EmanuelOrozco/axial-flux-generator/docs/latex/06_presentacion.tex

% Presentación de 10 minutos para público general (incluye la demostración en vivo del simulador).
% Compilar con: ./docs/compilar_pdf.sh 06_presentacion
\documentclass[aspectratio=169,11pt,xcolor={dvipsnames,table}]{beamer}
\usepackage[utf8]{inputenc}
\usepackage[T1]{fontenc}
\usepackage{lmodern}
\usepackage[spanish,es-nodecimaldot,es-noshorthands,es-tabla]{babel}
\usepackage{amsmath,amssymb}
\usepackage{siunitx}
\sisetup{output-decimal-marker={.},group-digits=false,per-mode=symbol}
\usepackage{booktabs}
\usepackage{tikz}
\usepackage{tcolorbox}
\usetikzlibrary{arrows.meta,positioning,calc}

\graphicspath{{../../simulacion/graficas/}{figuras/}}
\input{generado/valores.tex}

% ---------------------------------------------------------------- estilo
\definecolor{Azul}{HTML}{0D47A1}
\definecolor{Cian}{HTML}{00838F}
\definecolor{Naranja}{HTML}{E65100}
\definecolor{Rojo}{HTML}{C62828}
\definecolor{Verde}{HTML}{2E7D32}
\definecolor{Gris}{HTML}{455A64}
\definecolor{Cobre}{HTML}{B87333}

\usefonttheme{professionalfonts}
\setbeamercolor{frametitle}{fg=Azul}
\setbeamerfont{frametitle}{series=\bfseries,size=\Large}
\setbeamercolor{structure}{fg=Azul}
\setbeamercolor{block title}{bg=Azul,fg=white}
\setbeamercolor{block body}{bg=Azul!6}
\setbeamercolor{block title alerted}{bg=Naranja,fg=white}
\setbeamercolor{block body alerted}{bg=Naranja!7}
\setbeamercolor{block title example}{bg=Verde,fg=white}
\setbeamercolor{block body example}{bg=Verde!7}
\setbeamertemplate{navigation symbols}{}
\setbeamertemplate{itemize items}[circle]
\setbeamertemplate{blocks}[rounded]
\setbeamertemplate{footline}{%
  \leavevmode\hbox to\paperwidth{%
    \hspace{1em}{\color{Gris}\tiny Electricidad con imanes: un generador de flujo axial}\hfill
    {\color{Gris}\tiny\insertframenumber/\inserttotalframenumber}\hspace{1em}}%
  \vspace{0.6em}}

\newcommand{\dato}[2]{{\small\color{Gris}#1}\\[-1pt]{\Large\bfseries\color{Azul}#2}}

\title{Electricidad con imanes}
\subtitle{Cómo un disco con imanes que gira puede cargar una batería y encender un bombillo}
\date{}

\begin{document}

% ================================================================ 1. Portada  (0:15)
\begin{frame}[plain]
  \begin{tikzpicture}[remember picture,overlay]
    \fill[Azul] (current page.north west) rectangle ([yshift=-4.4cm]current page.north east);
    \node[anchor=north west,text=white,font=\sffamily\bfseries\LARGE,text width=10cm,align=left]
      at ([xshift=1cm,yshift=-1.3cm]current page.north west) {\inserttitle};
    \node[anchor=north west,text=white!85!Azul,font=\sffamily\normalsize,text width=10cm,align=left]
      at ([xshift=1cm,yshift=-2.4cm]current page.north west) {\insertsubtitle};
    \begin{scope}[shift={([xshift=-2.6cm,yshift=-2.2cm]current page.north east)},scale=0.5]
      \foreach \i in {0,...,7} {
        \pgfmathsetmacro{\ang}{45*\i}
        \ifodd\i \def\col{Azul!40}\def\pol{S}\else \def\col{Rojo!80}\def\pol{N}\fi
        \fill[\col] (\ang:2.2) circle (0.55);
        \node[white,font=\bfseries\small] at (\ang:2.2) {\pol};
      }
      \draw[white,line width=1pt] (0,0) circle (3.0);
      \fill[white!70] (0,0) circle (0.35);
    \end{scope}
  \end{tikzpicture}
  \vspace{4.2cm}
  \begin{columns}[T]
    \column{0.5\textwidth}
      \small Un generador de flujo axial, diseñado y simulado\\[2pt]
      \color{Gris}\footnotesize Teoría Electromagnética
    \column{0.42\textwidth}
      \footnotesize\color{Gris}
      Incluye una demostración en vivo del simulador 3D
  \end{columns}
\end{frame}

% ================================================================ 2. Qué construimos  (0:45)
\begin{frame}{¿Qué construimos?}
  \centering
  \begin{tikzpicture}[
      caja/.style={draw=Azul,fill=Azul!6,rounded corners=3pt,minimum height=1.05cm,
                   text width=1.75cm,align=center,font=\scriptsize},
      flecha/.style={-{Stealth[length=2.2mm]},thick,Gris},
      node distance=0.42cm]
    \node[caja,draw=Naranja,fill=Naranja!8] (mano) {Alguien gira\\el disco};
    \node[caja,right=of mano] (rotor) {Disco con\\\ValPolos{} imanes};
    \node[caja,right=of rotor] (bob) {\ValBobinas{} bobinas\\de cobre};
    \node[caja,right=of bob] (puente) {Convertidor\\AC \(\to\) DC};
    \node[caja,right=of puente] (mppt) {Cargador\\inteligente};
    \node[caja,right=of mppt,draw=Verde,fill=Verde!8] (bat) {Batería\\de \SI{12}{V}};
    \node[caja,below=0.9cm of bat] (inv) {Inversor\\\SI{110}{}/\SI{220}{V}};
    \node[caja,left=of inv,draw=Naranja,fill=Naranja!8] (foco) {Bombillo};
    \draw[flecha] (mano) -- (rotor);
    \draw[flecha] (rotor) -- (bob);
    \draw[flecha] (bob) -- (puente);
    \draw[flecha] (puente) -- (mppt);
    \draw[flecha] (mppt) -- (bat);
    \draw[flecha] (bat) -- (inv);
    \draw[flecha] (inv) -- (foco);
  \end{tikzpicture}

  \vspace{0.5cm}
  \begin{columns}[T]
    \column{0.31\textwidth}
      \begin{block}{La idea}\small
        Convertir movimiento en electricidad, como la dínamo de una bicicleta.
      \end{block}
    \column{0.31\textwidth}
      \begin{block}{El aparato}\small
        Un disco de imanes que gira frente a bobinas de cobre, con piezas impresas en 3D.
      \end{block}
    \column{0.31\textwidth}
      \begin{block}{La simulación}\small
        Un modelo por computador que reproduce el sistema completo en tiempo real.
      \end{block}
  \end{columns}
\end{frame}

% ================================================================ 3. La idea física  (1:00)
\begin{frame}{La idea: un imán en movimiento produce electricidad}
  \centering
  \begin{tikzpicture}[flecha/.style={-{Stealth[length=2.5mm]},very thick,Gris}]
    % imán
    \fill[Rojo!85] (0,0) rectangle (0.8,1.2);
    \fill[Azul!60] (0.8,0) rectangle (1.6,1.2);
    \node[white,font=\bfseries] at (0.4,0.6) {N};
    \node[white,font=\bfseries] at (1.2,0.6) {S};
    \draw[-{Stealth},thick,Naranja] (0,-0.35) -- node[below,font=\scriptsize,text=Naranja]{se mueve} (1.6,-0.35);
    \node[font=\footnotesize,align=center] at (0.8,-1.25) {\textbf{1.} El imán\\pasa cerca};
    \draw[flecha] (2.0,0.6) -- (3.0,0.6);
    % bobina
    \foreach \x in {3.5,3.75,...,4.75} \draw[Cobre,line width=1.6pt] (\x,0.6) ellipse (0.12 and 0.6);
    \node[font=\footnotesize,align=center] at (4.1,-1.25) {\textbf{2.} El campo magnético\\cambia en la bobina};
    \draw[flecha] (5.4,0.6) -- (6.6,0.6);
    % bombillo
    \fill[Naranja!25] (7.6,0.75) circle (0.75);
    \fill[yellow!80!Naranja] (7.6,0.75) circle (0.45);
    \fill[Gris] (7.4,-0.05) rectangle (7.8,0.2);
    \node[font=\footnotesize,align=center] at (7.6,-1.25) {\textbf{3.} Aparece una\\corriente eléctrica};
  \end{tikzpicture}

  \vspace{0.35cm}
  \begin{columns}[T]
    \column{0.47\textwidth}
      \begin{block}{Ley de Faraday}\small
        Cuanto más rápido cambia el campo, más voltaje se genera.
        Por eso, si el disco gira al doble de velocidad, el voltaje se duplica.
      \end{block}
    \column{0.47\textwidth}
      \begin{alertblock}{Ley de Lenz}\small
        La corriente generada frena el imán. Cuanta más electricidad pedimos, más cuesta girar,
        igual que pedalear con la dínamo encendida.
      \end{alertblock}
  \end{columns}
\end{frame}

% ================================================================ 4. El generador por dentro  (0:40)
\begin{frame}{El generador por dentro}
  \begin{columns}[c]
    \column{0.56\textwidth}
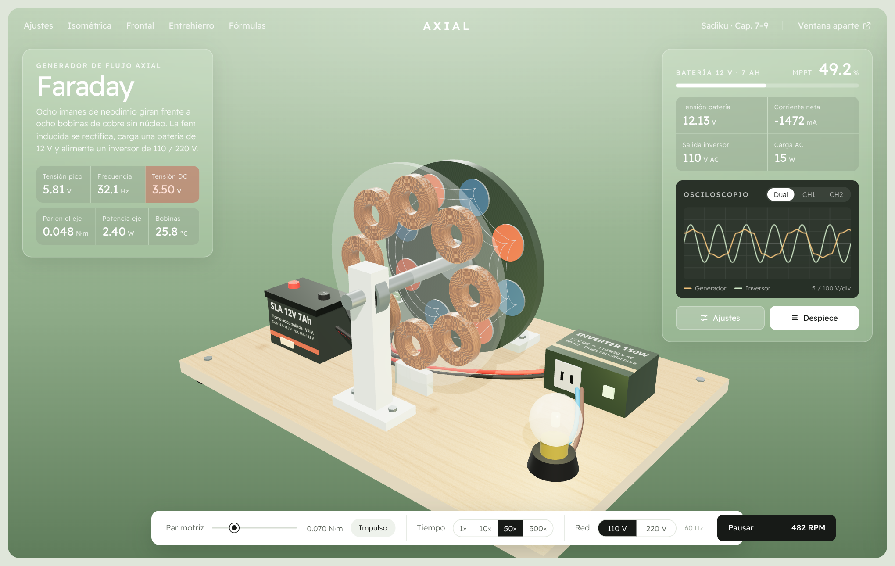
[picture p1: docs/latex/figuras/simulador_despiece.png]
      
    \column{0.41\textwidth}
      \begin{itemize}
        \setlength{\itemsep}{6pt}
        \item \textbf{\ValPolos{} imanes de neodimio}, del tamaño de una moneda (\SI{\ValDiametroIman}{mm}), alternando norte y sur.
        \item \textbf{\ValBobinas{} bobinas} con unos \SI{90}{m} de alambre de cobre en total.
        \item Imanes y bobinas separados solo \SI{\ValEntrehierro}{mm}: el campo se debilita rápido con la distancia.
        \item A \ValRpmReferencia{} vueltas por minuto (5 por segundo) genera unos \SI{\ValTensionRmsRef}{V}.
      \end{itemize}
  \end{columns}
\end{frame}

% ================================================================ 5. Qué tiene en cuenta la simulación  (0:50)
\begin{frame}{Una simulación lo más cercana posible a la realidad}
  \begin{columns}[c]
    \column{0.5\textwidth}
      \small
      \begin{itemize}
        \setlength{\itemsep}{4pt}
        \item \textbf{El disco pesa}: tarda en acelerar y en detenerse.
        \item \textbf{Hay rozamiento}: si se deja de girar, se para solo.
        \item \textbf{El cargador} solo funciona por encima de cierta velocidad.
        \item \textbf{La batería} no es un tanque perfecto: pierde parte de la energía al cargarse y se llena más despacio al final.
        \item \textbf{El inversor} consume energía aunque no haya nada conectado.
        \item \textbf{El calor} aumenta la resistencia del cobre y debilita los imanes.
      \end{itemize}
    \column{0.47\textwidth}
      
      \\{\scriptsize\color{Gris}Un empujón con la mano lleva el disco a unas \ValRpmPicoImpulso{} vueltas por minuto, y se detiene en unos \SI{\ValTiempoParadaImpulso}{s}.}
  \end{columns}
\end{frame}

% ================================================================ 6. Confiabilidad  (0:30)
\begin{frame}{¿Por qué confiar en la simulación?}
  \begin{columns}[T]
    \column{0.31\textwidth}
      \begin{block}{Basada en la física}\small
        Usa las mismas ecuaciones del curso de electromagnetismo (Sadiku).
      \end{block}
    \column{0.31\textwidth}
      \begin{block}{Dos versiones idénticas}\small
        El cálculo en Python y la simulación del navegador coinciden en sus primeras nueve cifras.
      \end{block}
    \column{0.31\textwidth}
      \begin{block}{Probada a fondo}\small
        Cada cambio se verifica con pruebas que revisan física, resultados e interfaz.
      \end{block}
  \end{columns}

  \vspace{0.7cm}
  \begin{columns}[T]
    \column{0.3\textwidth}\centering\dato{Pruebas automáticas}{138}
    \column{0.3\textwidth}\centering\dato{Gráficas generadas}{12}
    \column{0.3\textwidth}\centering\dato{Documentos técnicos}{5}
  \end{columns}
\end{frame}

% ================================================================ 7. Demo  (3:30)
\begin{frame}{Demostración en vivo}
  \begin{columns}[c]
    \column{0.56\textwidth}
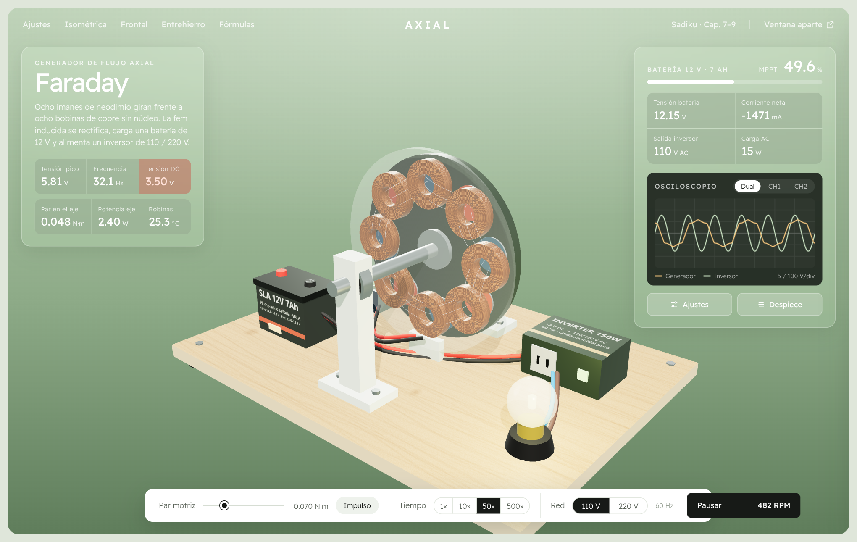
[picture p2: docs/latex/figuras/simulador_general.png]
      
    \column{0.41\textwidth}
      \small
      \begin{enumerate}
        \setlength{\itemsep}{2pt}
        \item Girar el disco y ver la electricidad generada.
        \item Darle un empujón y verlo frenar solo.
        \item Encontrar un giro constante.
        \item Encender el bombillo con la batería.
        \item Cargar la batería acelerando el tiempo.
        \item Separar imanes y bobinas.
        \item Ver el generador por dentro.
      \end{enumerate}
  \end{columns}
\end{frame}

% ================================================================ 8. Resultados  (0:50)
\begin{frame}{¿Cuánta energía produce?}
  \begin{columns}[T]
    \column{0.31\textwidth}\centering
      \dato{Girando suave}{\ValRpmRegimenRef{} RPM}\\[6pt]
      {\small unas 8 vueltas por segundo}
    \column{0.31\textwidth}\centering
      \dato{Llega a la batería}{\ValPotenciaBateriaRef{} W}\\[6pt]
      {\small suficiente para un LED}
    \column{0.31\textwidth}\centering
      \dato{Aprovechamiento}{\ValEficienciaRef{}\,\%}\\[6pt]
      {\small de cada 10 partes de esfuerzo, 4 llegan a la batería}
  \end{columns}

  \vspace{0.8cm}
  \begin{columns}[T]
    \column{0.47\textwidth}
      \begin{exampleblock}{Girando con toda la fuerza}\small
        Unas \ValRpmParMaximo{} vueltas por minuto y \SI{\ValPotenciaBateriaParMaximo}{W} hacia la batería.
      \end{exampleblock}
    \column{0.47\textwidth}
      \begin{alertblock}{La comparación}\small
        Un bombillo de \SI{15}{W} consume más de lo que el generador produce:
        la batería guarda la energía para usarla después.
      \end{alertblock}
  \end{columns}
\end{frame}

% ================================================================ 9. Conclusiones  (0:30)
\begin{frame}{Conclusiones}
  \begin{itemize}
    \setlength{\itemsep}{4pt}
    \item Un imán que se mueve cerca de una bobina genera electricidad: es el mismo principio de las centrales eléctricas.
    \item Generar electricidad siempre cuesta esfuerzo: la corriente frena el disco.
    \item Un generador pequeño produce poca energía, pero con una batería puede acumularla y encender un bombillo.
    \item La simulación permite probar el diseño antes de construirlo.
  \end{itemize}

  \vspace{0.4cm}
  \begin{tcolorbox}[colback=Azul!6,colframe=Azul,boxrule=0.8pt,arc=3pt,halign=center]
    \large\bfseries\color{Azul}
    Con imanes, cobre y movimiento se fabrica electricidad;\\
    la física explica cómo y la simulación muestra cuánto.
  \end{tcolorbox}

  \vspace{0.2cm}
  \begin{center}
    {\Large\bfseries\color{Azul}¿Preguntas?}
  \end{center}
\end{frame}

\end{document}
