EmanuelOrozco/axial-flux-generator/docs/latex/comun/preambulo.tex

% Preámbulo compartido por todos los documentos del proyecto (compilar con pdflatex).
\usepackage[utf8]{inputenc}
\usepackage[T1]{fontenc}
\usepackage{lmodern}
\usepackage{textcomp}
\usepackage[spanish,es-nodecimaldot,es-noshorthands,es-tabla]{babel}
\DeclareUnicodeCharacter{03A9}{\ensuremath{\Omega}}
\DeclareUnicodeCharacter{00B5}{\ensuremath{\mu}}
\DeclareUnicodeCharacter{03BC}{\ensuremath{\mu}}
\DeclareUnicodeCharacter{221A}{\ensuremath{\surd}}
\DeclareUnicodeCharacter{2192}{\ensuremath{\rightarrow}}
\DeclareUnicodeCharacter{2248}{\ensuremath{\approx}}
\DeclareUnicodeCharacter{2212}{\ensuremath{-}}
\DeclareUnicodeCharacter{2264}{\ensuremath{\le}}
\DeclareUnicodeCharacter{2265}{\ensuremath{\ge}}
\DeclareUnicodeCharacter{00D7}{\ensuremath{\times}}
\usepackage[a4paper,top=2.5cm,bottom=2.5cm,left=2.4cm,right=2.4cm,headheight=15pt]{geometry}
\setlength{\emergencystretch}{3em}
\usepackage{amsmath,amssymb,mathtools,bm}
\usepackage{siunitx}
\sisetup{output-decimal-marker={.},group-digits=false,per-mode=symbol,separate-uncertainty}
\usepackage{graphicx,float,booktabs,tabularx,longtable,array,multirow}
\usepackage[font=small,labelfont=bf]{caption}
\usepackage{enumitem}
\setlist{itemsep=2pt,topsep=4pt}
\usepackage[dvipsnames,table]{xcolor}
\usepackage[most]{tcolorbox}
\usepackage{tikz}
\usetikzlibrary{arrows.meta,positioning,shapes.geometric,calc,fit,backgrounds,decorations.markings}
\usepackage[european,straightvoltages]{circuitikz}
\usepackage{listings}
\usepackage{fancyhdr}
\usepackage{titlesec}
\usepackage{xurl}
\usepackage[colorlinks=true,linkcolor=Azul,urlcolor=Azul,citecolor=Azul]{hyperref}

\graphicspath{{../../simulacion/graficas/}{figuras/}}

% ---------------------------------------------------------------- colores
\definecolor{Azul}{HTML}{0D47A1}
\definecolor{Cian}{HTML}{00838F}
\definecolor{Naranja}{HTML}{E65100}
\definecolor{Rojo}{HTML}{C62828}
\definecolor{Verde}{HTML}{2E7D32}
\definecolor{Gris}{HTML}{455A64}
\definecolor{FondoCodigo}{HTML}{F5F7FA}

% ---------------------------------------------------------------- títulos
\titleformat{\section}{\Large\bfseries\color{Azul}}{\thesection}{0.8em}{}
\titleformat{\subsection}{\large\bfseries\color{Cian}}{\thesubsection}{0.8em}{}
\titleformat{\subsubsection}{\normalsize\bfseries\color{Gris}}{\thesubsubsection}{0.8em}{}

% ---------------------------------------------------------------- cabeceras
\pagestyle{fancy}
\fancyhf{}
\fancyhead[L]{\small\color{Gris}\nombredocumento}
\fancyhead[R]{\small\color{Gris}Generador de flujo axial con imanes NdFeB}
\fancyfoot[C]{\small\thepage}
\renewcommand{\headrulewidth}{0.4pt}

% ---------------------------------------------------------------- cajas
\newtcolorbox{nota}[1][Nota]{enhanced,breakable,colback=Azul!4,colframe=Azul!70,
  fonttitle=\bfseries,title={#1},left=6pt,right=6pt}
\newtcolorbox{advertencia}[1][Advertencia]{enhanced,breakable,colback=Rojo!4,colframe=Rojo!80,
  fonttitle=\bfseries,title={#1},left=6pt,right=6pt}
\newtcolorbox{resultado}[1][Resultado]{enhanced,breakable,colback=Verde!5,colframe=Verde!75,
  fonttitle=\bfseries,title={#1},left=6pt,right=6pt}
\newtcolorbox{paso}[1]{enhanced,breakable,colback=white,colframe=Cian!80,
  fonttitle=\bfseries,title={#1},left=6pt,right=6pt}

% ---------------------------------------------------------------- código
\lstdefinestyle{base}{
  basicstyle=\ttfamily\footnotesize,
  backgroundcolor=\color{FondoCodigo},
  frame=single,rulecolor=\color{Gris!40},
  breaklines=true,columns=fullflexible,keepspaces=true,
  keywordstyle=\color{Azul}\bfseries,
  commentstyle=\color{Verde}\itshape,
  stringstyle=\color{Naranja},
  showstringspaces=false,
  extendedchars=true,
  literate={á}{{\'a}}1 {é}{{\'e}}1 {í}{{\'i}}1 {ó}{{\'o}}1 {ú}{{\'u}}1 {ñ}{{\~n}}1
           {Á}{{\'A}}1 {É}{{\'E}}1 {Í}{{\'I}}1 {Ó}{{\'O}}1 {Ú}{{\'U}}1 {Ñ}{{\~N}}1
           {·}{{$\cdot$}}1 {→}{{$\rightarrow$}}1 {Ø}{{\O}}1 {Ω}{{$\Omega$}}1 {µ}{{$\mu$}}1
           {−}{{-}}1 {²}{{$^2$}}1 {√}{{$\surd$}}1 {≈}{{$\approx$}}1
}
\lstdefinestyle{python}{style=base,language=Python}
\lstdefinelanguage{JavaScript}{
  keywords={const,let,var,function,return,class,constructor,new,if,else,for,while,this,true,false,null,typeof,module,export,import},
  sensitive=true,comment=[l]{//},morecomment=[s]{/*}{*/},morestring=[b]',morestring=[b]",morestring=[b]`
}
\lstdefinestyle{js}{style=base,language=JavaScript}
\lstdefinestyle{consola}{style=base,keywordstyle=\color{black}}

% ---------------------------------------------------------------- utilidades
\newcommand{\vect}[1]{\mathbf{#1}}
\newcommand{\unitario}[1]{\mathbf{a}_{#1}}
\newcommand{\dif}{\mathrm{d}}
\DeclareUrlCommand\archivo{\urlstyle{tt}}
\makeatletter
\newcommand{\filasdesde}[1]{\@@input #1 }
\makeatother

\newcommand{\portada}[3]{%
  \begin{titlepage}
    \begin{tikzpicture}[remember picture,overlay]
      \fill[Azul] (current page.north west) rectangle ([yshift=-7cm]current page.north east);
      \node[anchor=north west,text=white,font=\sffamily\bfseries\Huge,text width=16cm,align=left]
        at ([xshift=2.4cm,yshift=-2.2cm]current page.north west) {#1};
      \node[anchor=north west,text=white!85!Azul,font=\sffamily\Large,text width=16cm,align=left]
        at ([xshift=2.4cm,yshift=-4.6cm]current page.north west) {#2};
    \end{tikzpicture}
    \vspace*{7cm}
    \begin{center}
      \begin{tikzpicture}[scale=0.9]
        \foreach \i in {0,...,7} {
          \pgfmathsetmacro{\ang}{45*\i}
          \ifodd\i \def\col{Azul!70}\def\pol{S}\else \def\col{Rojo!80}\def\pol{N}\fi
          \fill[\col] (\ang:2.2) circle (0.55);
          \node[white,font=\bfseries] at (\ang:2.2) {\pol};
        }
        \draw[Gris,line width=1pt] (0,0) circle (3.0);
        \fill[Gris!40] (0,0) circle (0.35);
      \end{tikzpicture}
    \end{center}
    \vfill
    {\large #3\par}
    \vspace{0.6cm}
    {\small\color{Gris}Basado en M.\,N.\,O. Sadiku, \emph{Elementos de Electromagnetismo}, 3.ª ed., Oxford University Press.\par
    Valores numéricos generados por el paquete \texttt{generador\_axial} (\texttt{uv run generador-axial reporte}).\par}
  \end{titlepage}
}

\input{generado/valores.tex}
