EmanuelOrozco/axial-flux-generator/docs/01_marco_teorico.pdf

# Marco teórico del generador de flujo axial

## Deducción paso a paso de las leyes electromagnéticas que gobiernan el prototipo

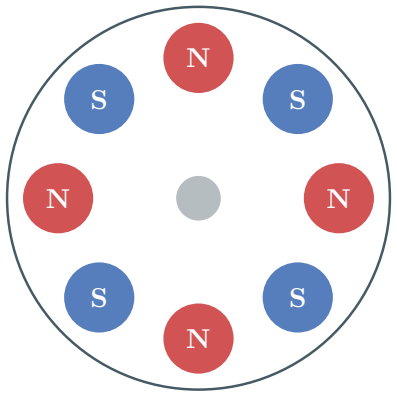
[picture p3: figure]

# Documento 1 de 5 · Fundamentos (Sadiku, Cap. 7, 8 y 9)

Basado en M. N. O. Sadiku, Elementos de Electromagnetismo, 3.ª ed., Oxford University Press.
Valores numéricos generados por el paquete generador_axial (uv run generador-axial reporte).

01 · Marco teórico | Generador de flujo axial con imanes NdFeB

## Índice

1. Objetivo y alcance | 2
2. Magnetostática: de Biot–Savart a la ley de Gauss magnética | 2
3. Materiales magnéticos e imanes de neodimio | 2
4. Campo axial de un imán cilíndrico: deducción completa | 3
5. Flujo magnético y flujo concatenado | 5
6. Ley de Faraday (Sec. 9.2) | 5
7. Fem de transformador y fem de movimiento (Sec. 9.3) | 5
8. Modelo del generador | 6
9. Circuito equivalente, potencia y ley de Lenz | 7
10.Rectificación y filtrado | 8
11.¿Por qué un estator sin núcleo de hierro? | 8
12.Micro-red: batería, controlador de carga e inversor | 8
13.Hipótesis y limitaciones del modelo | 9
14.Resumen de fórmulas | 10

## 1 Objetivo y alcance

Este documento explica por qué funciona el generador y de dónde salen cada una de las ecuaciones que usan el modelo de simulación (src/generador_axial), el visualizador 3D y la guía de fabricación. Ninguna fórmula se presenta sin su deducción: se parte de la ley de Biot– Savart y de la ley de Faraday y se llega, paso a paso, a la tensión que se medirá en los bornes del prototipo.
El generador estudiado tiene la siguiente topología:

Rotor: un disco con P = 8 imanes cilíndricos de NdFeB (∅ 20 × 5.0 mm) montados a un radio de 40.0 mm, con polaridad alternada N–S–N–S.

Estator: un disco fijo con Nb = 8 bobinas de núcleo de aire de N = 180 espiras.

Entrehierro: g = 2.5 mm entre la cara de los imanes y la cara de las bobinas.

Sobre la numeración de Sadiku

Las secciones citadas corresponden a la 3.ª edición en español de Elementos de Electromagnetismo: Cap. 7 (Campos magnetostáticos: Biot–Savart, Ampère, Sec. 7.5 densidad de flujo), Cap. 8 (Fuerzas, materiales y dispositivos magnéticos: Sec. 8.2 fuerzas, Sec. 8.5 imanación, Sec. 8.6 clasificación de materiales) y Cap. 9 (Campos variables: Sec. 9.2 ley de Faraday, Sec. 9.3 fem de transformador y de movimiento). En otras ediciones la numeración puede variar ligeramente.

## 2 Magnetostática: de Biot–Savart a la ley de Gauss magnética

### 2.1 Ley de Biot–Savart (Cap. 7)

Un elemento de corriente I dl produce en un punto situado a un vector R de él la densidad de flujo

dB =

µ0
4π

I dl × aR
R²
, | µ0 = 4π × 10⁻⁷ H/m. | (1)

Para una distribución superficial de corriente K (en A/m) basta sustituir I dl → K dS.

### 2.2 Ley de Gauss para el campo magnético (Sec. 7.5)

I

S

B · dS = 0 | ⇐⇒ | ∇ · B = 0. | (2)

Paso a paso: la forma diferencial se obtiene aplicando el teorema de la divergencia, H
S B · dS = R
V ∇ · B dv = 0, que debe cumplirse para cualquier volumen V ; por tanto el integrando es nulo en todo punto.
Consecuencia para el generador: las líneas de B son cerradas. Todo el flujo que sale de la cara Norte de un imán debe regresar a su cara Sur. En el rotor con polos alternados ese retorno se hace, en buena parte, a través del imán vecino (de polaridad opuesta), lo que concentra el flujo en las bobinas que están enfrente.

## 3 Materiales magnéticos e imanes de neodimio

### 3.1 Imanación y corrientes ligadas (Sec. 8.5)

En un material, los momentos magnéticos atómicos se describen con el vector imanación M (momento dipolar por unidad de volumen, A/m). Se cumple

B = µ0 (H + M). | (3)

Sadiku demuestra que el efecto de M es idéntico al de dos distribuciones de corriente ligada:

Jb = ∇ × M (volumétrica), | Kb = M × an | (superficial). | (4)

### 3.2 Ferromagnéticos duros (Sec. 8.6)

El NdFeB (Nd2Fe14B) es un ferromagnético duro: su ciclo de histéresis es muy ancho. Las dos cifras que lo caracterizan son:

Remanencia Br: densidad de flujo que conserva sin campo externo.

Coercitividad Hc: campo inverso necesario para anular B (> 850 kA/m). Es tan grande que las corrientes inducidas en las bobinas no pueden desmagnetizar el imán.

Tabla 1: Grados comerciales típicos de NdFeB.

Grado | N35 | N38 | N42 | N48 | N52
Br típica [T] 1.19 | 1.24 | 1.30 | 1.40 | 1.45

El prototipo usa Br = 1.25 T (grado N38, cuya remanencia comercial va de 1.22 a 1.26 T).

## 4 Campo axial de un imán cilíndrico: deducción completa

### 4.1 Paso 1: el imán es un solenoide equivalente

Un imán cilíndrico de radio R y espesor L con imanación uniforme M = M az cumple:

1. En el interior M es constante, así que Jb = ∇ × M = 0.
2. En las caras planas an = ±az, de modo que Kb = Maz × (±az) = 0.
3. En la cara lateral an = aρ, de modo que Kb = Maz × aρ = M aϕ.

Es decir, el imán equivale a una lámina cilíndrica de corriente azimutal K = M: exac-tamente un solenoide de longitud L con nI = M amperios-vuelta por metro.

### 4.2 Paso 2: campo de una espira circular en su eje

Tomemos una espira de radio R en el plano z

′ = 0 con corriente I, y un punto del eje a una altura z.
1. La distancia de cualquier punto de la espira al punto de observación es √
R² + z

2, constante.

2. Por simetría, las componentes radiales de dB se cancelan dos a dos; sólo sobrevive la axial.
3. El ángulo entre dl y R es 90◦

, y la proyección axial de dB introduce el factor R/√ R² + z

2:

| dBz = | µ0I dl
4π(R² + z
| | | 2)

·

| | | | R
√
| | | | R² + z

2

4. Integrando dl sobre la circunferencia (H dl = 2πR):

B

| espira
z
(z) = µ0IR²

2 (R² + z

| | | | 2) 3/2
. | (5)

### 4.3 Paso 3: superposición de espiras (solenoide finito)

Situamos el imán entre z

′ = −L y z

′ = 0, de forma que su cara Norte está en z = 0 y el espacio de trabajo es z > 0. Una rebanada de espesor dz

′
transporta la corriente K dz

′ y, por (5),

dBz =

µ0KR² dz

′

2 (R² + (z − z

′)
2)

3/2

1. Cambio de variable u = z − z

′
, du = −dz

′
. Los límites cambian: z

′ = −L ⇒ u = z + L;
z

′ = 0 ⇒ u = z.

2. La integral queda Bz =

µ0KR²

2

Z z+L

z

du
(R² + u

2)

3/2

3. Primitiva conocida: Z

du
(R² + u

2)

3/2

=

u
R²

√
R² + u

2

(se comprueba derivando).

4. Evaluando y simplificando R² :

Bz(z) = µ0K
2

"
z + L
p
(z + L)

2 + R²

−

z
√
z

2 + R²

5. Para un imán permanente con permeabilidad de retroceso µr ≈ 1 (NdFeB: 1.05), µ0M = Br. Con K = M:

Campo axial del imán

Bz(z) = Br
2

"
z + L
p
(z + L)

2 + R²

−

z
√
z

2 + R²

(6)

### 4.4 Paso 4: comprobaciones de la fórmula

En la cara (z = 0): Bz(0) = Br
2

L
√
L² + R²

. Para el prototipo, 0.2795 T.

Imán muy largo (L → ∞, z = 0): Bz → Br/2, el valor conocido en el extremo de un solenoide semi-infinito.

Campo lejano (z ≫ R, L): desarrollando en serie se obtiene

Bz ≈

BrR²L

2 d

3

,

con d la distancia al centro del imán. Es el campo de un dipolo m = MπR²L en su eje, B = µ0m/(2πd³
). El paquete de pruebas verifica este límite.

### 4.5 Paso 5: campo medio en el espesor de la bobina

Las espiras de la bobina no están en un único plano: ocupan desde su cara (z = g) hasta su cara posterior (z = g + h), con h = 6.0 mm. Lo correcto es promediar:

B¯
z =

1
h

Z g+h

g

Bz(z) dz.

1. Primitivas de cada término de (6):
Z

z + L
p
(z + L)

2 + R²

dz =

q
(z + L)

2 + R²,

Z

z
√
z

2 + R²

dz =

p
z

2 + R².

2. Definimos F(z) = p
(z + L)

2 + R² −

√
z

2 + R².

Campo medio en la bobina

B¯
z =

Br
2h

h
F(g + h) − F(g)

i
(7)

Corrección respecto a la versión anterior del proyecto

El modelo original evaluaba Bz sólo en z = g (0.2234 T). El promedio exacto da 0.1545 T: la versión anterior sobreestimaba el flujo, y por tanto la tensión, en un 30.8 %.

## 5 Flujo magnético y flujo concatenado

El flujo a través de una superficie S es Φ = R
S B · dS (Wb). Si una bobina tiene N espiras que abrazan prácticamente el mismo flujo, el flujo concatenado es Ψ = NΦ. Para una espira enfrentada a un imán aproximamos

Φmax = k B¯
z πR²
, | (8)

donde πR²
es el área de la cara del imán y k ∈ (0, 1] es el factor de acoplamiento, que agrupa lo que el modelo axial no recoge: la disminución de Bz fuera del eje, el flujo de retorno que atraviesa las espiras exteriores en sentido contrario y la dispersión en el entrehierro. Se usa k = 0.85.

## 6 Ley de Faraday (Sec. 9.2)

E =

I

L

E · dl = −

dΨ
dt

= −N

dΦ
dt
. | (9)

Forma diferencial paso a paso. Para un contorno fijo:

1. H
L E · dl = −

d
dt

Z

S

B · dS = −

Z

S

∂B
∂t · dS (el contorno no se mueve).
2. Teorema de Stokes: H
L E · dl =

R
S

(∇ × E) · dS.

3. Igualando para cualquier superficie S:

∇ × E = −

∂B
∂t . | (10)

## 7 Fem de transformador y fem de movimiento (Sec. 9.3)

Sadiku distingue tres casos:

Espira fija, campo variable: Etr = −

Z

S

∂B
∂t · dS, | (11)

Espira móvil, campo estático: Em =

I

L

(u × B) · dl, | (12)
Caso general: E = Etr + Em. | (13)

La fem de movimiento proviene de la fuerza de Lorentz F = q(E + u × B): para una carga que se mueve con el conductor, u × B actúa como un campo eléctrico efectivo.
Aplicación al generador.

Marco del estator: las bobinas están quietas; en su posición el campo cambia al pasar polos alternos: es una fem de transformador.

Marco del rotor: el campo de los imanes es estático y son las bobinas las que se mueven con u = −ωm × r: es una fem de movimiento.

Ambas descripciones dan el mismo resultado: para u ≪ c las transformaciones de los campos entre marcos se reducen a E′ = E+u× B, de modo que lo que en un marco aparece como ∂B/∂t en el otro aparece como u × B.

## 8 Modelo del generador

### 8.1 Paso polar y frecuencia eléctrica

1. Con P polos repartidos uniformemente, el paso polar es θp = 2π/P (45.0◦ para P = 8).
2. Un ciclo eléctrico completo (N → S → N frente a una bobina) requiere girar dos pasos polares, 2θp = 4π/P.
3. En una vuelta (2π) hay por tanto P/2 ciclos eléctricos.
4. Con RPM/60 vueltas por segundo:

fe =

P
2

·

RPM
60

=

P · RPM
120

, ωm =

2π RPM
60

, ωe = 2πfe =

P
2
ωm. | (14)

### 8.2 Forma del flujo en una bobina

El flujo que atraviesa una bobina es una función periódica del ángulo del rotor con periodo 2θp, y cambia de signo cada θp (polo N → polo S). Su primer armónico de Fourier es

Φ(t) = Φmax cos(ωet), | (15)

tomando t = 0 cuando un imán N está centrado sobre la bobina. El modelo conserva sólo este armónico fundamental, que es el que domina en topologías sin hierro con imanes circulares.

### 8.3 Fem de una bobina

Aplicando (9):

1.

dΦ
dt

= −Φmax ωe sin(ωet) (regla de la cadena).

2. E1(t) = −N

dΦ
dt

= N ωe Φmax sin(ωet).

### 8.4 Conexión en serie con polaridad alternada

La bobina j (j = 0, . . . , Nb − 1) está desplazada un ángulo jθp, por lo que ve Φj (t) = Φmax cos(ωet − jπ) = (−1)j Φmax cos(ωet): las bobinas vecinas tienen flujos opuestos. Si todas se conectaran en el mismo sentido, sus fem se cancelarían por pares. Conectando la bobina j con signo sj = (−1)j
(final con final, inicio con inicio):

Etotal =

N

Xb−1

j=0

sj Ej =

X

j

(−1)j

(−1)j NωeΦmax sin(ωet) = NbN ωeΦmax sin(ωet).

Fem del generador

E(t) = Vpico sin(ωet), | Vpico = Ntotal ωe Φmax, | Ntotal = NbN = 1440. | (16)

### 8.5 Valor eficaz

Por definición V

2
RMS =

1
T

R T
0

E

2dt. Usando sin² x =

1−cos 2x
2

y que el coseno promedia cero en un periodo:

V

2
RMS =

V

2
pico
T

Z T

0

1 − cos(2ωet)
2

dt =

V

2
pico
2

⇒ VRMS =

Vpico
√
2
. | (17)

## 9 Circuito equivalente, potencia y ley de Lenz

### 9.1 Resistencia interna

Para una bobina con diámetros interior Di y exterior De, la espira media tiene diámetro (Di + De)/2:

ℓm = π

Di + De
2
, | Rint = ρCu

Ntotal ℓm

ACu

, ACu =

πd²

4

. | (18)

Corrección

La versión anterior usaba un radio medio de 12 mm; con Di = 12 mm y De = 28 mm el radio medio real es 10 mm. Con el valor corregido, Rint = 12.14 Ω.

Al ser bobinas sin núcleo su inductancia es pequeña y Zint = Rint + jωeLint ≈ Rint.

### 9.2 Teorema de máxima transferencia de potencia

Con una carga resistiva RL (circuito de Thévenin, valores eficaces):

1. I =

VRMS

Rint + RL

, PL = I

2RL =

V

2
RMSRL

(Rint + RL)

2

2. Derivando respecto a RL:

dPL
dRL

= V

2
RMS

(Rint + RL) − 2RL

(Rint + RL)

3

= V

2
RMS

Rint − RL

(Rint + RL)

3

3. Se anula para RL = Rint (es un máximo: la derivada pasa de positiva a negativa).
4. Pmax =

V

2
RMS
4Rint

, con rendimiento η =

RL

Rint + RL

, que vale 50 %.

### 9.3 Ley de Lenz y par resistente

El signo menos de (9) indica que la corriente inducida crea un flujo que se opone a la variación que la produjo. Mecánicamente:

1. Cada tramo de conductor con corriente sufre dF = I dl × B (Sec. 8.2).
2. La reacción sobre los imanes produce un par τ = r × F opuesto a ωm.
3. Conservación de la energía: la potencia mecánica entregada al eje iguala la potencia eléctrica total
Pmec = τ ωm = I

2
(Rint + RL) = PL + PCu | ⇒ | τ =

PL + PCu
ωm
. | (19)

No hay energía gratuita: cuanto más corriente se extrae, más cuesta girar el rotor.

## 10 Rectificación y filtrado

1. En el puente de Graetz conducen dos diodos en serie en cada semiciclo; la tensión de pico disponible en la salida es Vpico − 2VD.
2. El condensador C se carga al valor de pico y, entre picos, alimenta la carga. Con rectificación de onda completa los picos se repiten cada 1/(2fe).
3. Si la carga extrae una corriente casi constante IDC, el condensador pierde ∆Q = IDC/(2fe) y su tensión cae ∆V = ∆Q/C:
VDC ≈ Vpico − 2VD, | ∆Vpp ≈ IDC 2feC
| . | (20)

Con diodos 1N4007 VD ≈ 0.7 V; con Schottky 1N5819 VD ≈ 0.30 V (valor del modelo).

## 11 ¿Por qué un estator sin núcleo de hierro?

Con hierro: µr ∼ 10³ aumenta el flujo, pero aparecen pérdidas por histéresis (∝ f Bn ),
por corrientes parásitas (∝ f

2B²
) y un fuerte par de reluctancia (cogging): el rotor “se engancha” en posiciones preferentes.

Sin hierro (coreless): µr ≈ 1, cero cogging, sin pérdidas en el núcleo, sin saturación. El sistema es lineal y la ley de Faraday se verifica de forma limpia: ideal para un laboratorio.

## 12 Micro-red: batería, controlador de carga e inversor

El generador alimenta una micro-red aislada: controlador DC-DC → batería de 12 V / 7 Ah → inversor de 110 V o 220 V a 60 Hz → bombillo de 15W. La física electromagnética termina en la tensión del generador; el resto es teoría de circuitos y de electrónica de potencia, salvo el transformador del inversor, que vuelve a ser la ley de Faraday.

### 12.1 Modelo de la batería

1. Se modela como una fuente Eoc que depende del estado de carga (SoC) en serie con una resistencia Rbat = 0.05 Ω:
Eoc(SoC) = 11.8 + 1.0 · SoC V, | Vbat = Eoc + InetaRbat. | (21)
2. El SoC se integra con la corriente neta (conteo de Coulomb), con Q = C · 3600 s:

d SoC
dt

=

Icarga − Idescarga
Q
| . | (22)
3. Protección por baja tensión: el inversor se desconecta al 20 % y se reconecta al 25 %. La histéresis evita que la salida oscile en el umbral.

### 12.2 Controlador de carga con seguimiento del punto de máxima potencia

El generador es una fuente de Thévenin con Rint = 12.14 Ω. Un controlador DC-DC que emula una carga RL = Rint extrae, por el teorema de máxima transferencia,

Pmax =

V

2
RMS
4Rint

, Icarga = m´ın

ηc Pmax
Eoc(SoC)

, Imax,

Vabs − Eoc

Rbat

, | (23)

con ηc = 90 %, Imax = 3.0 A y Vabs = 14.4 V. El controlador no arranca si VDC < 3.5 V.

Corrección

La versión modificada del proyecto calculaba la potencia con V

2
DC/(4Rint). Como VDC ≈

Vpico =

√
2 VRMS, eso duplicaba la potencia disponible. La forma correcta usa el valor eficaz de la fem.

### 12.3 Inversor y transformador elevador (Sec. 8.8 y 9.3)

1. Un puente de MOSFET conmuta la batería con modulación senoidal (SPWM); el filtro LC deja sólo el armónico fundamental de 60 Hz.
2. El transformador eleva la tensión por la fem de transformador: ambos devanados comparten el flujo Φ(t), y por Faraday v1 = N1 dΦ/dt y v2 = N2 dΦ/dt. Por tanto

V2
V1

=

N2
N1

≈

155.6 V
12 V
≈ 13.0. | (24)
3. Balance de potencia con eficiencia ηinv = 90 %:

Pin =

PAC

ηinv

, | Idescarga =

PAC

ηinv Eoc

. | (25)

### 12.4 Balance energético y velocidad de equilibrio

La potencia neta que recibe la batería es

Pneta = ηc

V

2
RMS
4Rint

−

PAC

ηinv

. | (26)

Como VRMS ∝ RPM, la velocidad que equilibra el consumo (Pneta = 0) es

RPMeq = RPMref

p
4RintPAC/(ηcηinv)

VRMS(RPMref )

. | (27)

Resultado

Para el bombillo de 15W se necesitan ≈ 1704 RPM, por encima del rango del prototipo (1200 RPM). Por tanto el generador recarga la batería y es la batería la que alimenta el inversor. Una carga de 5W se equilibra a ≈ 984 RPM.

## 13 Hipótesis y limitaciones del modelo

1. Se usa el campo en el eje del imán; fuera del eje Bz es menor (lo absorbe k).
2. Se conserva sólo el armónico fundamental del flujo.
3. Se desprecian la inductancia de las bobinas y la variación de ρCu con la temperatura (≈ 0.39 %/K).
4. El rotor es de una sola cara y sin placa de retorno de hierro; un rotor doble (imanes a ambos lados del estator) aproximadamente duplicaría el flujo.
5. k debe calibrarse con la medición: kreal = k · Vmedido/Vteórico.

## 14 Resumen de fórmulas

Magnitud | Expresión | Unidad
Velocidad angular mecánica | ωm = 2π RPM/60 | rad/s
Frecuencia eléctrica | fe = P · RPM/120 | Hz
Campo axial del imán | Bz = Br
| 2

h
| √ z+L
| (z+L) 2+R² − √ z
| z 2+R²

i
| | T
Campo medio en la bobina | B¯
| z = Br
| 2h - F(g + h) − F(g)
| | T
Flujo máximo por espira | Φmax = k B¯
| z πR² | Wb
Fem pico total | Vpico = Ntotal ωe Φmax | V
Fem eficaz | VRMS = Vpico/

√
| 2 | V
Tensión rectificada | VDC ≈ Vpico − 2VD | V
Rizado | ∆Vpp ≈ IDC/(2feC) | V
Resistencia interna | Rint = ρCuNtotalπ(Di + De)/(2ACu) | Ω
Potencia en la carga | PL = V
| 2
| RMSRL/(Rint + RL)
| 2 | W
Par resistente (Lenz) | τ = (PL + PCu)/ωm | N·m
Tensión de la batería | Eoc = 11.8 + 1.0 · SoC | V
Corriente de carga (MPPT) | Icarga = ηcV
| 2
| RMS/(4RintEoc) | A
Relación del transformador | V2/V1 = N2/N1 | –
Corriente del inversor | Idescarga = PAC/(ηinvEoc) | A

Los valores numéricos de cada una de estas magnitudes para el prototipo se calculan paso a paso en el Documento 2: Memoria de cálculo.
