EmanuelOrozco/axial-flux-generator/docs/02_memoria_de_calculo.pdf

# Memoria de cálculo

## Cálculo numérico paso a paso del prototipo: campo, flujo, tensión, resistencia, potencia y par


# Documento 2 de 5 · Resultados del modelo analítico

Basado en M. N. O. Sadiku, Elementos de Electromagnetismo, 3.ª ed., Oxford University Press.
Valores numéricos generados por el paquete generador_axial (uv run generador-axial reporte).

02 · Memoria de cálculo | Generador de flujo axial con imanes NdFeB

## Índice

1. Cómo se obtuvo cada número | 2
2. Datos de entrada | 2
3. Campo magnético | 2
4. Flujo magnético | 3
5. Cinemática a 300 RPM (velocidad de referencia) | 4
6. Tensión inducida | 4
7. Resistencia interna y ocupación de la bobina | 5
8. Operación con carga a 400 RPM | 6
9. Verificación de la etapa de salida | 7
10.Micro-red a 600 RPM | 7
11.Tabla de ensayos prevista | 10
12.Verificación automática del modelo | 10

## 1 Cómo se obtuvo cada número

Todos los valores de este documento se escriben a partir del archivo docs/latex/generado/ valores.tex, que genera automáticamente el comando

uv run generador-axial reporte

a partir del diseño definido en src/generador_axial/configuracion.py. Si se cambia un parámetro del diseño (por ejemplo, el número de espiras) y se recompilan los PDF con docs /compilar_pdf.sh, todas las cifras de este documento se actualizan solas. Así se evita que la documentación y el código digan cosas distintas.
Cada paso sigue la misma estructura: fórmula (deducida en el Documento 1) → sustitución de los datos → resultado.

## 2 Datos de entrada

Tabla 1: Parámetros del diseño.

Símbolo | Descripción | Valor
Br | Remanencia del imán (grado N38) | 1.25 T
R | Radio del imán (∅ 20 mm) | 10.0 mm
L | Espesor del imán | 5.0 mm
P | Número de polos | 8
rm | Radio de montaje de imanes y bobinas | 40.0 mm
Nb | Número de bobinas | 8
N | Espiras por bobina | 180
Di
, De | Diámetros interior y exterior de la bobina | 12.0 / 28.0 mm
h | Altura (espesor axial) de la bobina | 6.0 mm
g | Entrehierro (cara del imán a cara de la bobina) | 2.5 mm
k | Factor de acoplamiento | 0.85
AWG | Calibre del alambre (cobre ∅ 0.404 mm, esmaltado ∅ 0.455 mm) | 26
ρCu | Resistividad del cobre a 20 ◦C | 1.72×10⁻⁸ Ω·m
VD | Caída por diodo (Schottky) | 0.30 V
C | Condensador de filtro | 220 µF / 50 V
RLED | Resistencia limitadora del LED | 2200 Ω, 0.50 W

## 3 Campo magnético

## Paso 1 · Área de la cara del imán

| Aim = πR² = π (10.0 mm)

2 = 314.16 mm² = 3.1416 × 10⁻⁴ m²

## Paso 2 · Campo en la cara del imán (z = 0)

Con z = 0 el segundo término de la fórmula del campo se anula:

| Bz(0) = Br
| 2 L
√
| L² + R² =
| 1.25
| 2

·

| 5.0
| 11.1803 =
| 1.25
| 2
- 0.4472 = | 0.2795 T

(Las longitudes pueden ir en mm porque aparecen como cociente.)

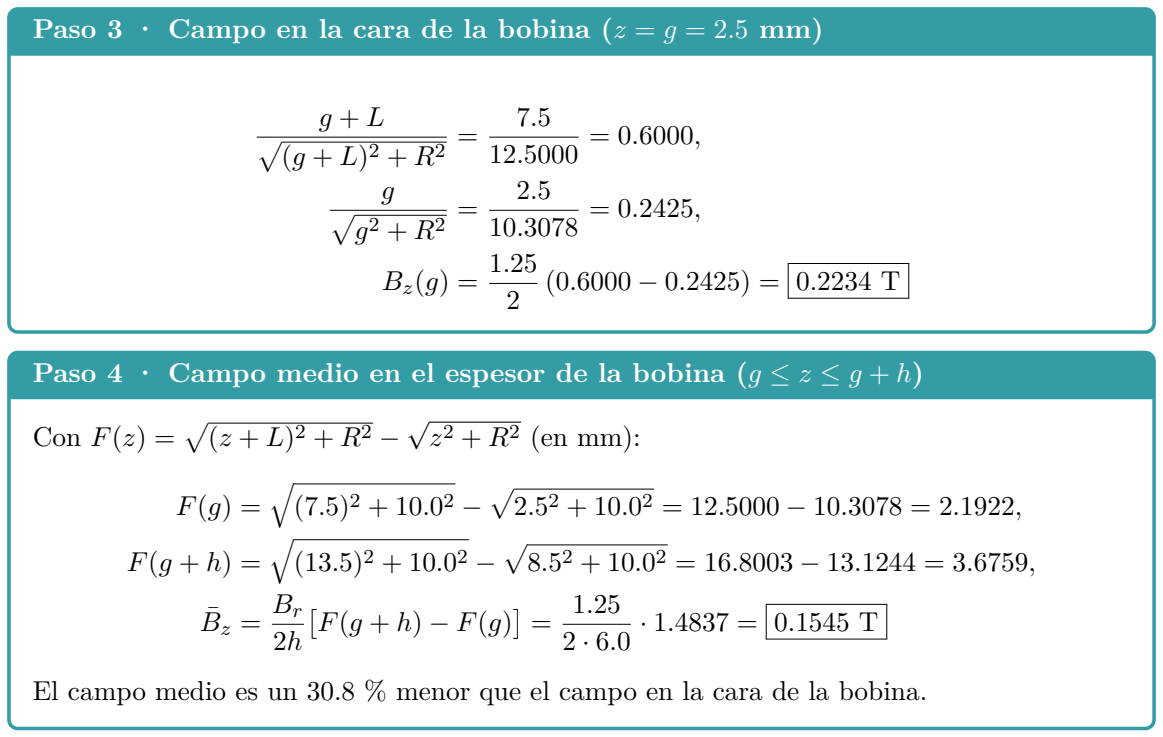
[picture p4: figure]
Con F(z) = p (z + L)

## Paso 3 · Campo en la cara de la bobina (z = g = 2.5 mm)

## Paso 4 · Campo medio en el espesor de la bobina (g ≤ z ≤ g + h)

El campo medio es un 30.8 % menor que el campo en la cara de la bobina.

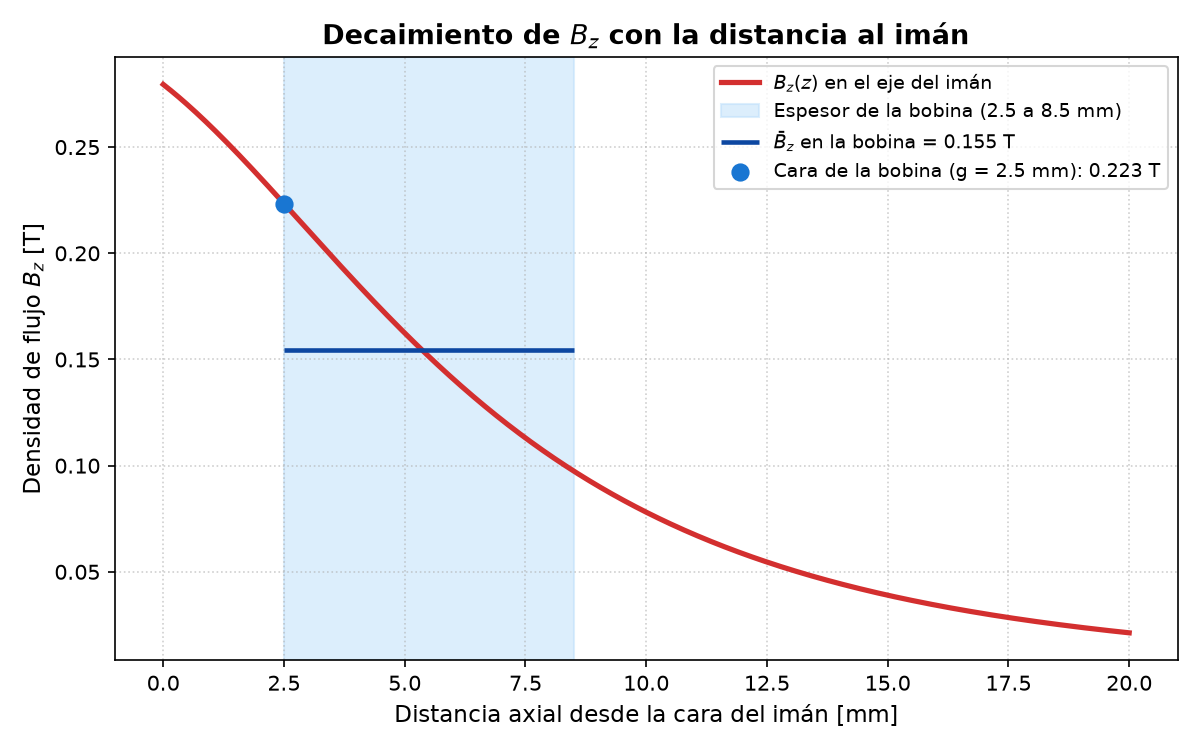
[picture p5: figure]

Figura 1: Campo axial Bz(z). La franja azul es el volumen ocupado por las espiras; la línea horizontal es el promedio B¯
z que se usa en el cálculo del flujo.

## 4 Flujo magnético

## Paso 5 · Flujo máximo por espira

Φmax = k B¯

z Aim = 0.85 × 0.1545 T × 3.1416 × 10⁻⁴ m² = 41.270 µWb

## 5 Cinemática a 300 RPM (velocidad de referencia)

## Paso 6 · Velocidades y frecuencia

ωm =

2π · RPM
60

=

2π · 300
60

= 31.416 rad/s,

fe =

P · RPM
120

=

8 · 300
120
= | 20.00 Hz | ,

ωe = 2πfe =

P
2

ωm = 125.66 rad/s, Te =

1
fe

= 50.00 ms.

## 6 Tensión inducida

## Paso 7 · Fem pico, eficaz y rectificada a 300 RPM

Ntotal = Nb · N = 8 × 180 = 1440,

Vpico = Ntotal ωe Φmax = 1440 × 125.66 × 41.270 × 10⁻⁶ = | 7.47 V | ,

Vpico, bobina = Vpico/Nb = 0.933 V,

VRMS =

Vpico
√
2

=

7.47
1.4142
= | 5.28 V | ,
VDC ≈ Vpico − 2VD = 7.47 − 0.60 = | 6.87 V | .

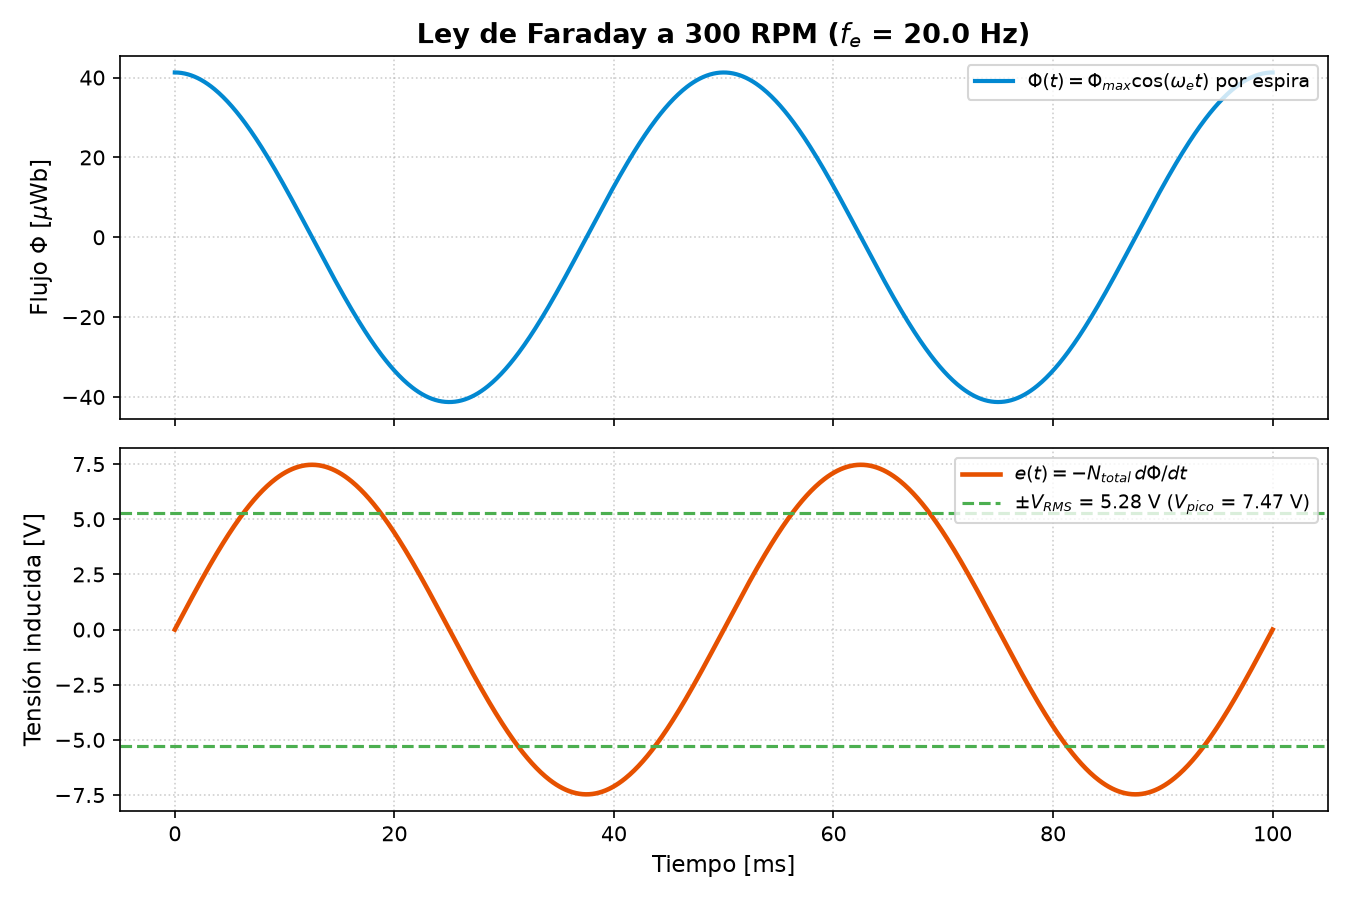
[picture p6: figure]

Figura 2: Flujo por espira Φ(t) y fem total e(t) = −Ntotal dΦ/dt a 300 RPM. La fem es máxima cuando

el flujo pasa por cero (máxima pendiente) y nula cuando el flujo es máximo.

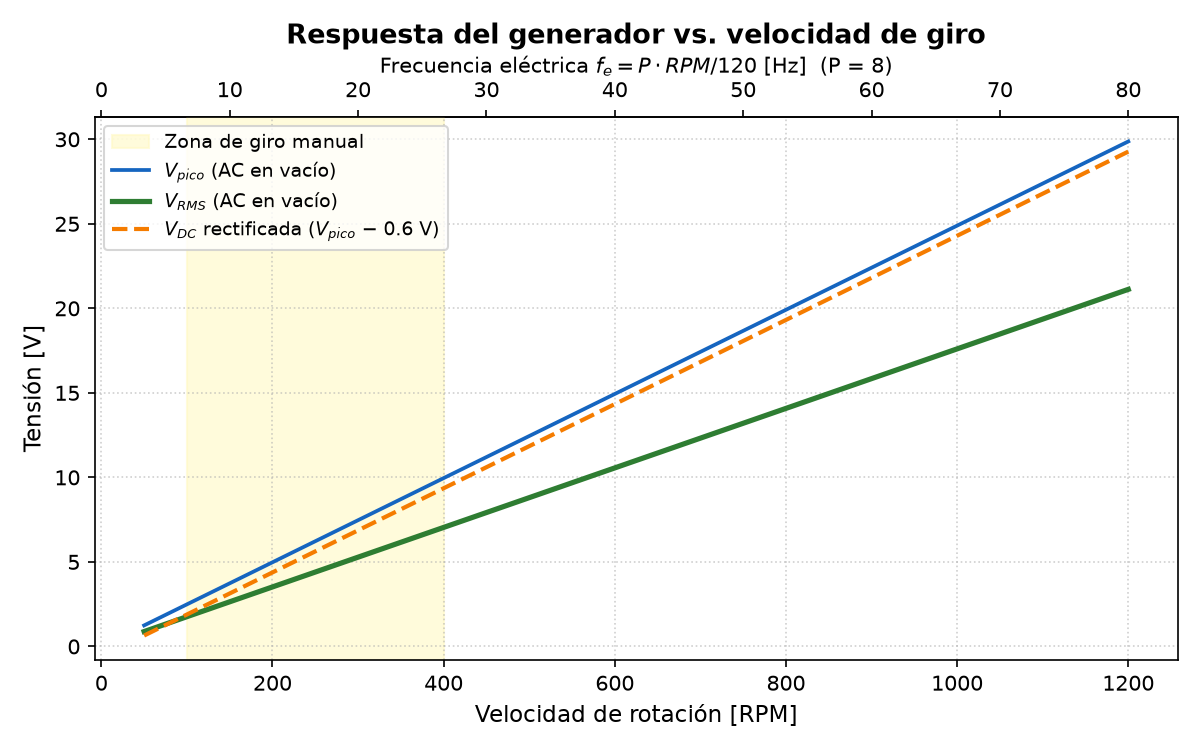
[picture p7: figure]

Figura 3: Las tensiones crecen linealmente con la velocidad porque Vpico ∝ ωe ∝ RPM. El eje superior

muestra la frecuencia eléctrica correspondiente.

## 7 Resistencia interna y ocupación de la bobina

## Paso 8 · Longitud de alambre

ℓm = π

Di + De
2

= π

12.0 + 28.0
2

= 62.83 mm,

Lbobina = N ℓm = 180 × 62.83 mm = 11.31 m,

Ltotal = Nb Lbobina = 90.48 m.

## Paso 9 · Resistencia

ACu =

πd²

4

=

π (0.404)²

4

= 0.1282 mm²
,

Rbobina = ρCu

Lbobina

ACu

= 1.517 Ω,

Rint = Nb Rbobina = | 12.14 Ω | .

Este es el valor que debe medirse con el multímetro entre los terminales de salida (a 20 ◦C).

## Paso 10 · ¿Caben las espiras? (factor de ocupación)

La ventana de bobinado mide De−Di
2 × h = 48.0 mm²
. Si cada espira ocupa un cuadrado de lado igual al diámetro esmaltado:

ocupación =

N d²
esm
ventana

=

180 × 0.455²

| 48.0
= | 0.78

Un valor por debajo de 0.85 es realizable con bobinado manual ordenado. El modelo rechaza diseños con ocupación mayor que 1.

## 8 Operación con carga a 400 RPM

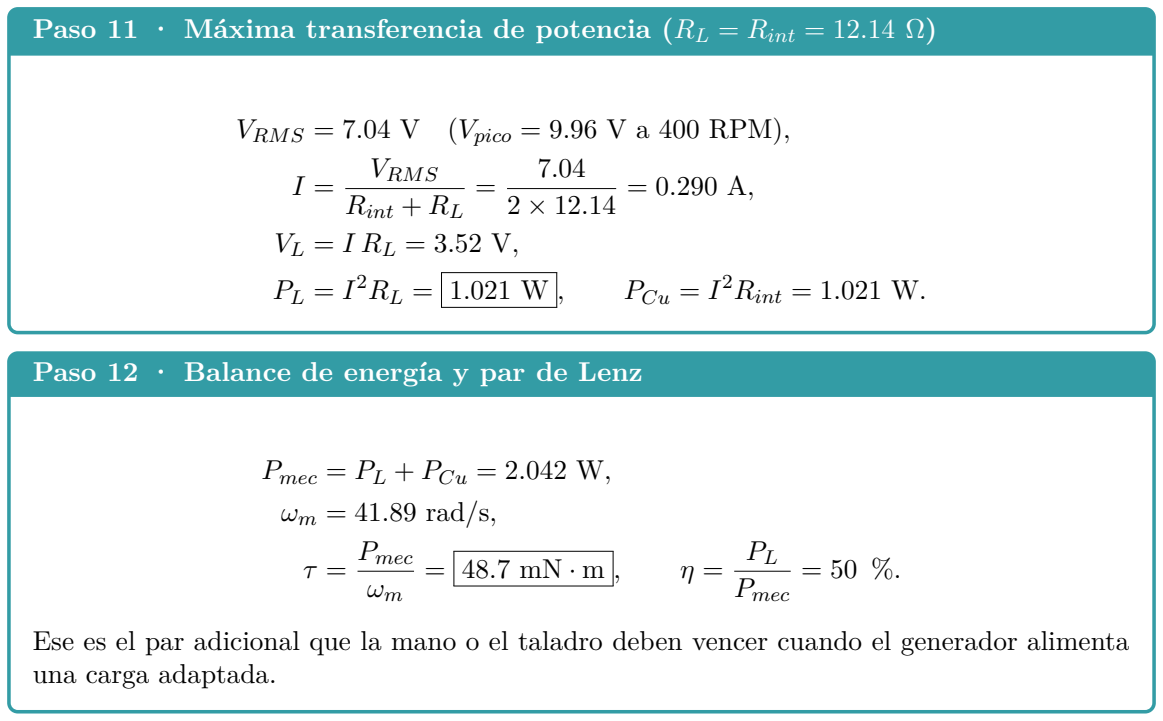
[picture p8: figure]
VRMS; Rint + RL; PCu = I; 2Rint = 1.021 W.; Pmec = PL + PCu = 2.042 W,; ωm = 41.89 rad/s,; Pmec; una carga adaptada.

## Paso 11 · Máxima transferencia de potencia (RL = Rint = 12.14 Ω)

VRMS = 7.04 V (Vpico = 9.96 V a 400 RPM),

## Paso 12 · Balance de energía y par de Lenz

Ese es el par adicional que la mano o el taladro deben vencer cuando el generador alimenta

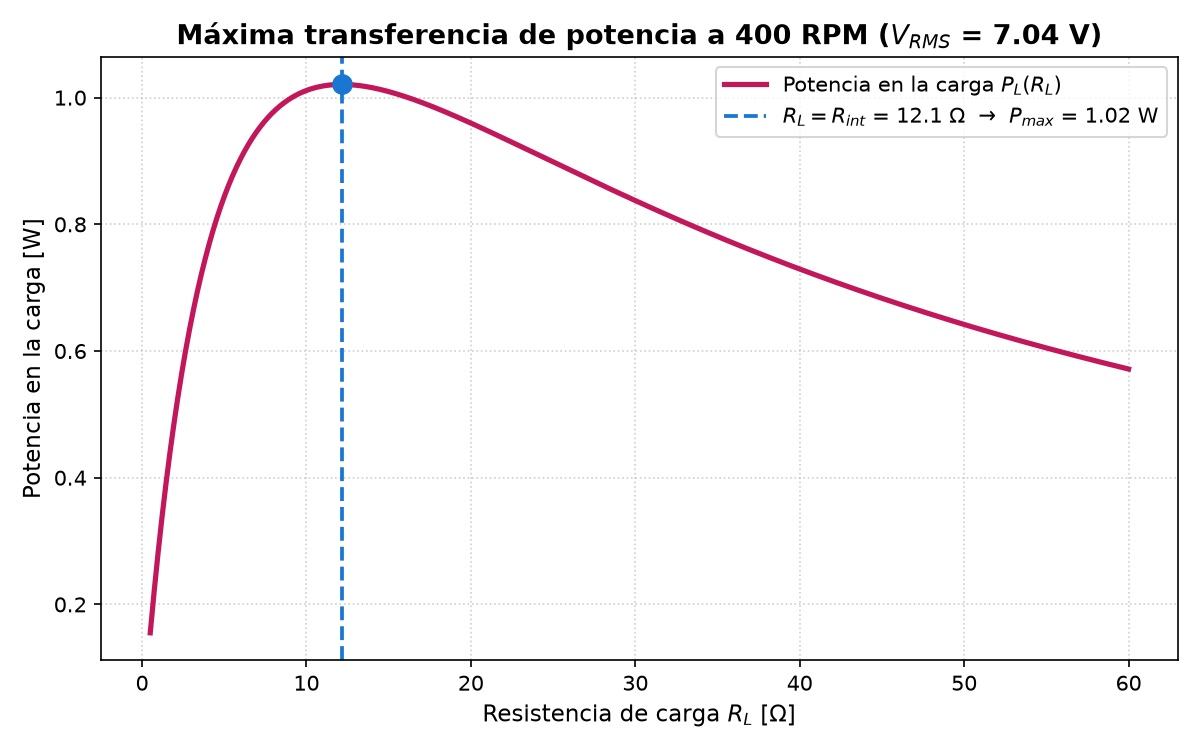
[picture p9: figure]

Figura 4: Potencia en la carga en función de RL: el máximo está exactamente en RL = Rint.

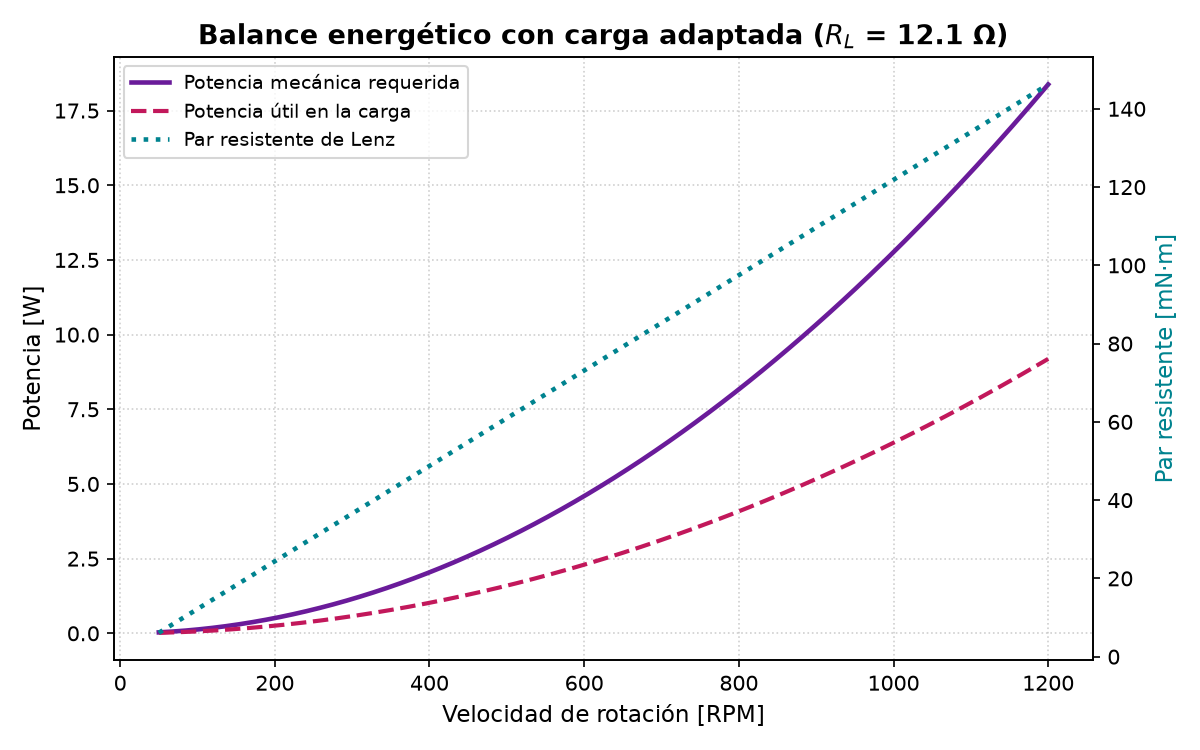
[picture p10: figure]

Figura 5: Con carga adaptada la potencia crece con el cuadrado de la velocidad (P ∝ V 2 ∝ RPM²
) y el
par resistente crece linealmente (τ = P/ωm ∝ RPM).

## 9 Verificación de la etapa de salida

## Paso 13 · Condensador, LED y rizado

Tensión máxima a 1200 RPM: VDC = 29.27 V. El condensador de 50 V queda con

un margen del 41 % (uno de 25 V se dañaría).

LED a 1200 RPM: ILED =

VDC − VLED

RLED

=

29.27 − 2.0
2200

= 12.4 mA (límite 20 mA) y

la resistencia disipa I

2R = 0.338 W (nominal 0.50 W).

Rizado a 300 RPM con el LED como carga (I = 2.21 mA):

∆Vpp =

I
2feC

=

2.21 × 10⁻³
2 × 20.00 × 220 × 10⁻⁶

= 251.4 mV.

## 10 Micro-red a 600 RPM

## Paso 14 · Batería (estado inicial SoC = 50 %)

E = Vnom C = 12 V × 7 Ah = 84 Wh,
Eoc = 11.8 + 1.0 × 0.50 = 12.30 V,
Eutil = (SoC − SoCcorte) E = (0.50 − 0.20) × 84 = 25.2 Wh.

El inversor se desconecta al 20 % y vuelve a conectarse al 25 %.

## Paso 15 · Carga con seguimiento del punto de máxima potencia

VRMS = 10.56 V, VDC = 14.34 V > 3.5 V (arranca),

Pmax =

V

2
RMS
4Rint

=

10.56²
4 × 12.14

= 2.297 W,

Pbat = ηc Pmax = 0.90 × 2.297 = | 2.067 W | ,

Icarga =

Pbat

Eoc

=

2.067
12.30

= 168 mA (< 3.0 A, no se limita),

Pmec = Pmax + I

2Rint = 4.59 W, τ = 73.1 mN · m.

Sin consumo, recargar del 50 % al 100 % tomaría (1 − 0.50) × 7/0.168 ≈ 20.8 h.

## Paso 16 · Inversor de 110 V / 220 V a 60 Hz

Vpico =

√
2 × 110 = 155.6 V (

√
| 2 × 220 = 311.1 V),
N2
N1

≈

155.6
12

= 13.0,

IAC =

PAC

VRMS

=

15
110

= 136 mA,

Pin =

PAC

ηinv

=

15
0.90

= 16.67 W, Idescarga =

Pin

Eoc

= 1.36 A.

La potencia de 15W está muy por debajo de la nominal del inversor (150W).

## Paso 17 · Balance de la batería y autonomía

Pneta = Pbat − Pin = 2.067 − 16.67 = | −14.60 W | ,

tauto ≈

Eutil

|Pneta|

= 1.73 h (1.51 h con el generador parado).

## Paso 18 · Velocidad de equilibrio

Como Pbat ∝ RPM²
, la velocidad que anula Pneta para 15W es

RPMeq = 600r
16.67
2.067

≈ 1704 RPM.

Supera las 1200 RPM del prototipo: con 15W la batería siempre se descarga. Con 5W

el equilibrio se alcanza a ≈ 984 RPM.

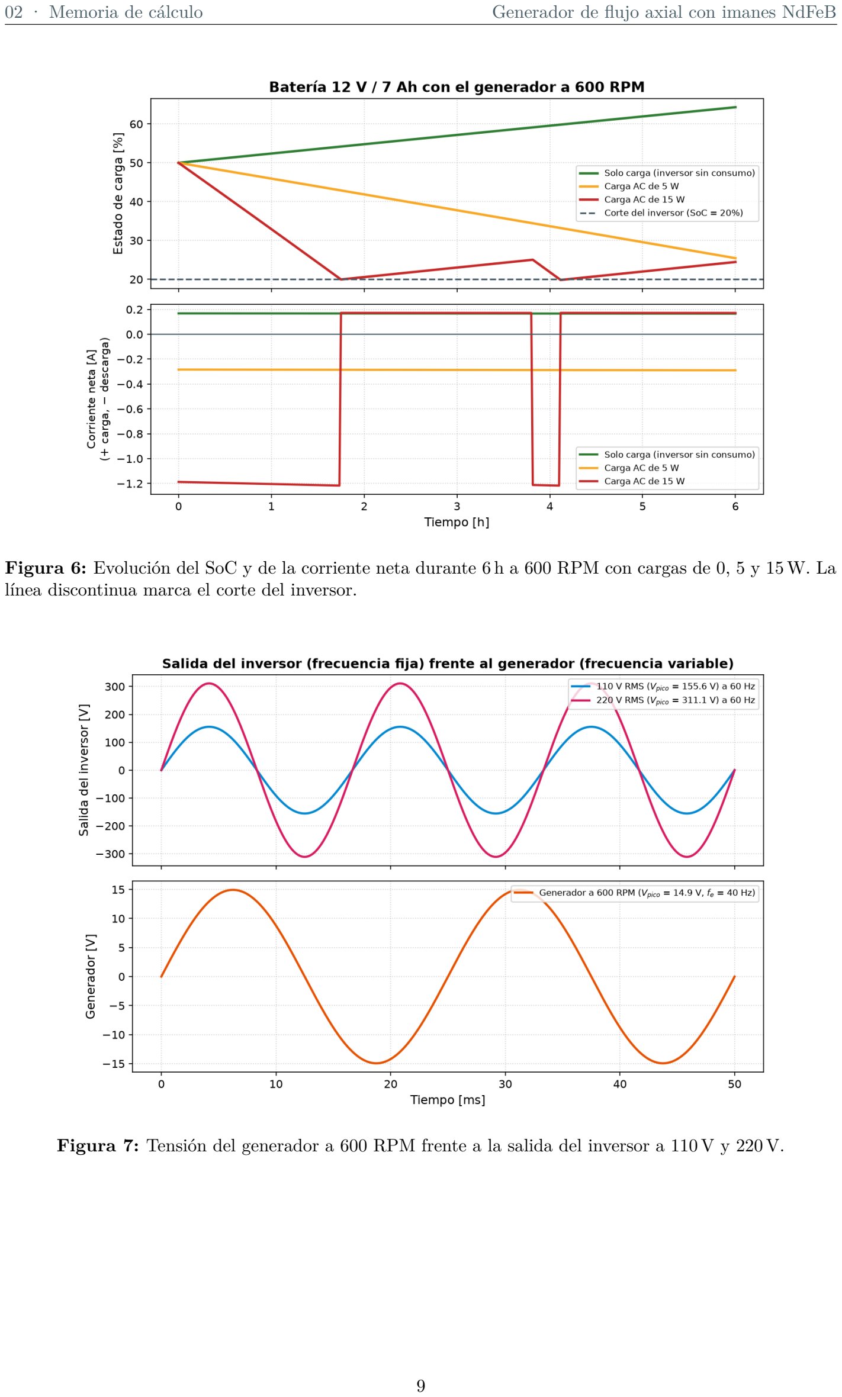
[picture p11: page 10]

Figura 6: Evolución del SoC y de la corriente neta durante 6 h a 600 RPM con cargas de 0, 5 y 15W. La

línea discontinua marca el corte del inversor.

Figura 7: Tensión del generador a 600 RPM frente a la salida del inversor a 110 V y 220 V.

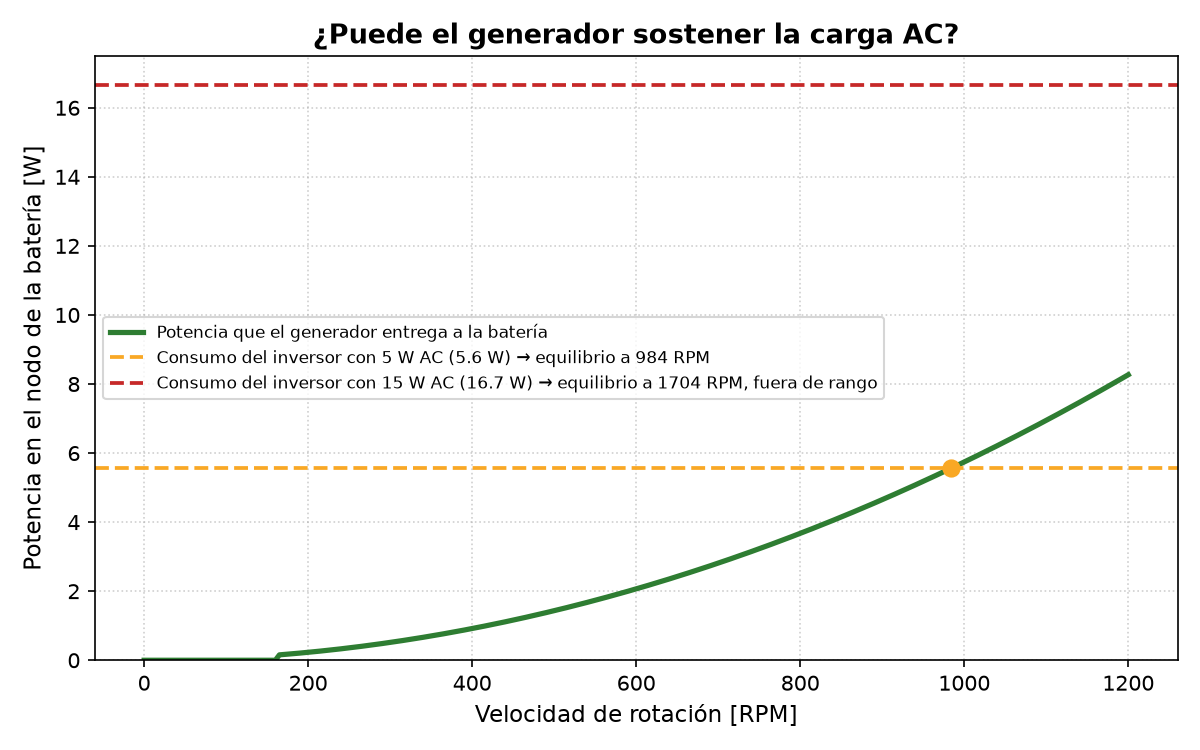
[picture p12: figure]

Figura 8: Potencia que llega a la batería frente al consumo del inversor. Los cruces son las velocidades

de equilibrio.

## 11 Tabla de ensayos prevista

Tabla 2: Valores teóricos para el protocolo de pruebas (columnas en blanco: medidas del laboratorio).

Ensayo | RPM | fe [Hz] | Vpico [V] | VRMS [V] | VDC [V] | VRMS med. | VDC med. | LED
1 | 150 | 10.0 | 3.73 | 2.64 | 3.13
2 | 300 | 20.0 | 7.47 | 5.28 | 6.87
3 | 600 | 40.0 | 14.94 | 10.56 | 14.34
4 | 1000 | 66.7 | 24.89 | 17.60 | 24.29

## 12 Verificación automática del modelo

El paquete de pruebas (uvrunpytest) comprueba en cada cambio que:
1. Bz(0) coincide con Br
| | 2

√

| | | L L²+R²
y que a gran distancia el campo coincide con el de un dipolo equivalente (error menor al 0.1 %).
2. El promedio analítico B¯
z coincide con una integración numérica de 20 001 puntos (error relativo < 10⁻⁸
).
3. La fem calculada coincide con −Ntotal dΦ/dt obtenida por derivación numérica.
4. La potencia máxima aparece en RL = Rint y se cumple τ ωm = PL + PCu.
5. La salida DC no supera el 80 % de la tensión del condensador ni la potencia de la resistencia del LED.
6. Las piezas STL son sólidos cerrados cuyo volumen coincide con el analítico (error menor al 0.5 %).
7. La micro-red conserva la energía, respeta los límites del controlador, corta el inversor al 20 % y reconecta al 25 %.

8. El visualizador web (JavaScript) da exactamente los mismos resultados que Python.
