EmanuelOrozco/axial-flux-generator/docs/05_modelo_realista.pdf

# Modelo realista

## Dinámica del rotor, forma de onda real, electrónica con sus límites, batería de plomo-ácido, inversor y temperatura


# Documento 5 de 5 · Simulación dinámica del sistema completo

Basado en M. N. O. Sadiku, Elementos de Electromagnetismo, 3.ª ed., Oxford University Press.
Valores numéricos generados por el paquete generador_axial (uv run generador-axial reporte).

05 · Modelo realista | Generador de flujo axial con imanes NdFeB

## Índice

1. Del modelo ideal al modelo realista | 2
2. Forma de onda real de la fem | 2
3. Circuito eléctrico con sus límites | 3
4. Batería de plomo-ácido | 4
5. Inversor y controlador | 5
6. Dinámica del rotor | 5
7. Modelo térmico | 7
8. Verificación | 7

## 1 Del modelo ideal al modelo realista

Los Documentos 1 y 2 describen el generador en régimen permanente con hipótesis de libro de texto: la velocidad se impone, el flujo es senoidal (Φ = kB¯
zA cos θe), la fuente tiene solo resistencia, la batería es una fuente ideal con resistencia y el inversor tiene eficiencia constante. Esas hipótesis son excelentes para dimensionar, pero no describen lo que se observa al construir el prototipo:

el rotor no gira a la velocidad que uno quiere: gira a la que resulta del equilibrio entre el par que se aplica, el rozamiento y el frenado de Lenz de la corriente que entrega;

la fem no es senoidal: su forma la decide el solape geométrico entre el imán circular y la bobina;

la batería no es una fuente ideal: su tensión sube al cargar (polarización), el controlador cambia de etapa (MPPT, absorción, flotación) y la capacidad depende de la corriente (Peukert);

el inversor consume aunque no haya carga y se desconecta por baja tensión;

las bobinas se calientan: la resistencia del cobre sube y el imán pierde remanencia.

El modelo realista integra en el tiempo todas esas físicas acopladas. Está implementado en Python (dominio/realista.py, dominio/dinamica.py, aplicacion/simulacion_dinamica.p
y) y, operación por operación, en el visualizador (visualizador_3d/js/modelo/dinamica.js). La prueba tests/test_paridad_visualizador.py compara ambas implementaciones paso a paso en cuatro guiones (arranque, absorción, flotación y corte por baja tensión) con tolerancia

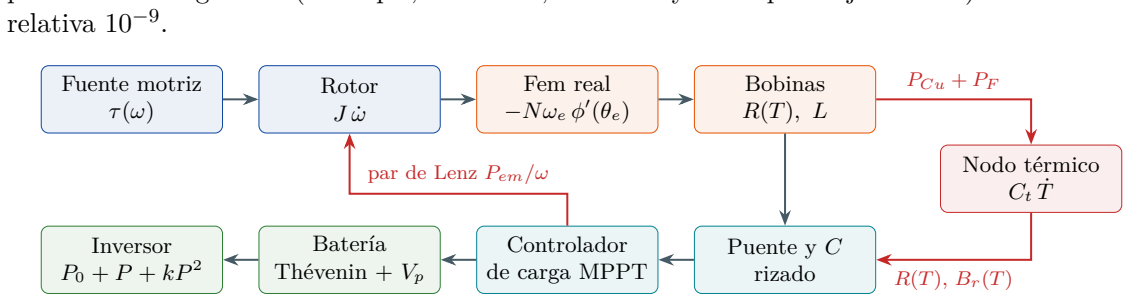
[picture p17: figure]
relativa 10⁻⁹; Fuente motriz τ (ω); Rotor J ω˙; Fem real −Nωe ϕ; Bobinas R(T), L; Puente y C rizado; Controlador de carga MPPT; Batería Thévenin + Vp; Inversor P0 + P + kP²; Nodo térmico Ct T˙; par de Lenz Pem/ω; PCu + PF

Figura 1: Acoplamientos del modelo realista. Las flechas rojas son las realimentaciones que el modelo ideal ignora.

## 2 Forma de onda real de la fem

El imán es un disco de radio rm = 10.0 mm y cada espira de la bobina es una circunferencia de radio ρ entre Di/2 y De/2. Si B¯
z es uniforme sobre la huella del imán y nulo fuera de ella, el flujo que concatena una espira es B¯
z por el área de intersección de dos círculos (una “lente”):

Alente(ρ, rm, d) = ρ

2
arc cos

d

2 + ρ

2 − r

2
m
2dρ + r

2
m arc cos

d

2 + r

2
m − ρ

2

2drm

−

1/2 q
(−d + ρ + rm)(d + ρ − rm)(d − ρ + rm)(d + ρ + rm),

donde d es la distancia entre centros. Al girar el rotor, los imanes de polaridad alterna pasan sobre la bobina; sumando su contribución con signo y promediando sobre las espiras (repartidas uniformemente en ρ):

ϕ(θe) = Φ
B¯
zAim

=

1

Aim

DX

k

(−1)kAlente
ρ, rm, dk(θe)

E

ρ

, e(t) = −Ntotal B¯
zAim ωe

dϕ
dθe

El perfil se evalúa con 32 radios y 256 muestras por periodo eléctrico.

Resultado · forma de onda

Flujo máximo normalizado ϕmax = 0.827: muy cercano al factor de acoplamiento k = 0.85 que se supuso en el Documento 2, lo que valida esa hipótesis.
Factor de cresta de la fem = 1.335 (una senoide tiene √
2 = 1.414): la onda es más aplanada, casi trapezoidal.

ERMS,real/ERMS,ideal =

√
2 rms(ϕ

′
)/k = 0.930: el modelo ideal sobreestima la fem eficaz en un ≈7 %.

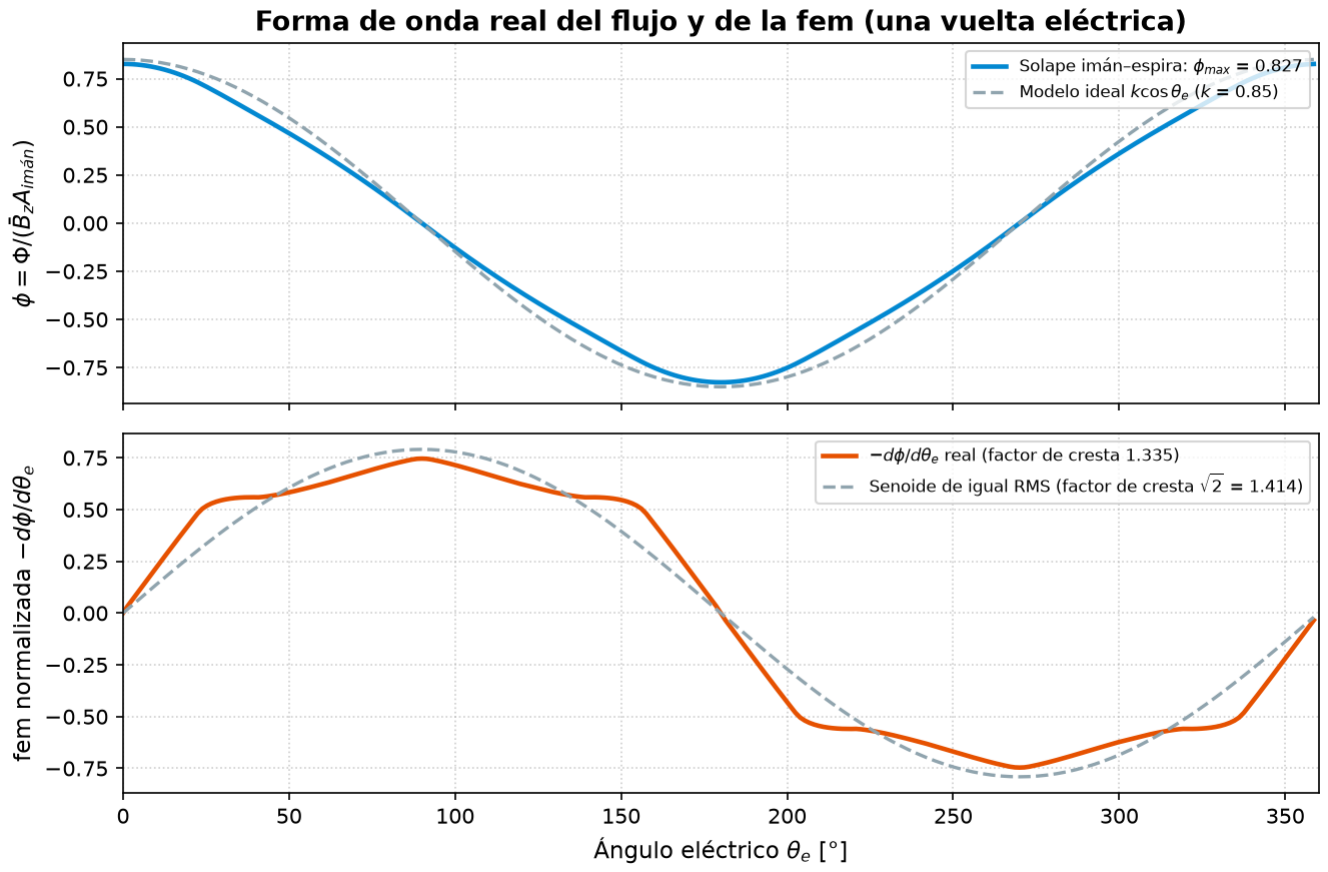
[picture p18: figure]

Figura 2: Flujo normalizado y fem por solape imán–espira frente al modelo senoidal ideal.

## 3 Circuito eléctrico con sus límites

### 3.1 Bobinas: resistencia con temperatura e inductancia

R(T) = R20 -

1 + αCu(T − 20 ◦C)
, αCu = 0.393 %/K;

Lbobina =

0.8 N²
r¯

2

6¯r + 9h + 10c

(Wheeler, en pulgadas) = 0.528 mH.

Las ocho bobinas en serie suman L = 4.22 mH, con reactancia X = ωeL. Como el estator no tiene hierro, no hay par de retención (cogging) ni histéresis; sí hay pequeñas corrientes de Foucault en el propio cobre: PF = 1.65 mW a 483 RPM.

### 3.2 Puente rectificador, condensador y controlador MPPT

Con corriente eficaz I, la potencia que llega al bus DC es

PDC(I) = I

p
E² − X²I

2 − RI² − 2VD

¯I, ¯I =
2

√
2
π

I.

El controlador busca dPDC/dI = 0 (bisección), pero no puede bajar el bus de 3.5 V, y limita la potencia de salida por la tensión de la batería (absorción 14.4 V; flotación 13.8 V cuando SoC ≥ 99.5 %) y por corriente (3.0 A). El rizado del bus es

∆V =

¯I
2feC

Hallazgo · el condensador de 220 µF es insuficiente

Con 0.2 N·m el rizado es de 18.8 V con 220 µF y de 0.88 V con 4700 µF. El generador entrega corriente a baja frecuencia (decenas de Hz), por lo que el condensador debe ser de miles de microfaradios. El visualizador lo señala con una alerta en la tarjeta de tensión DC y permite elegir 220, 1000, 2200 o 4700 µF.

## 4 Batería de plomo-ácido

Se usa el circuito equivalente de Thévenin de primer orden (corriente I > 0 cargando):

Vbornes = Eoc(SoC) + Vp + R0I, | τ V˙
p = Rp(SoC, I) I − Vp,

Rp = Rp0

1 + A eB(SoC−1)
(I > 0), SoC˙ =

ηc(SoC) I
C

(carga), SoC˙ = −

Ief
C

(descarga).

Tabla 1: Parámetros de la batería (12 V, 7 Ah, AGM).

Símbolo | Descripción | Valor
R0 | Resistencia óhmica | 25 mΩ
Rp0, τ | Polarización (difusión del electrolito) | 30 mΩ, 30 s
A, B | Sobrepotencial de gasificación al final de la carga | 1500, 50
kP | Exponente de Peukert (régimen C/20) | 1.12
ηc | Eficiencia coulómbica (por encima del 85 % baja a 60 %) | 95 %
– | Autodescarga | 3 %/mes

Acoplamiento implícito

Al imponer la tensión de absorción, el controlador y la polarización de la batería forman un lazo muy rápido. Con un paso explícito el lazo oscila; por eso la batería se evalúa con la polarización al final del paso: con retención a = e

| −h/τ
, Eef = Eoc +Vpa y Ref = R0 +Rp(1− a). Es un esquema implícito exacto para el circuito lineal, estable para cualquier factor de aceleración del tiempo.

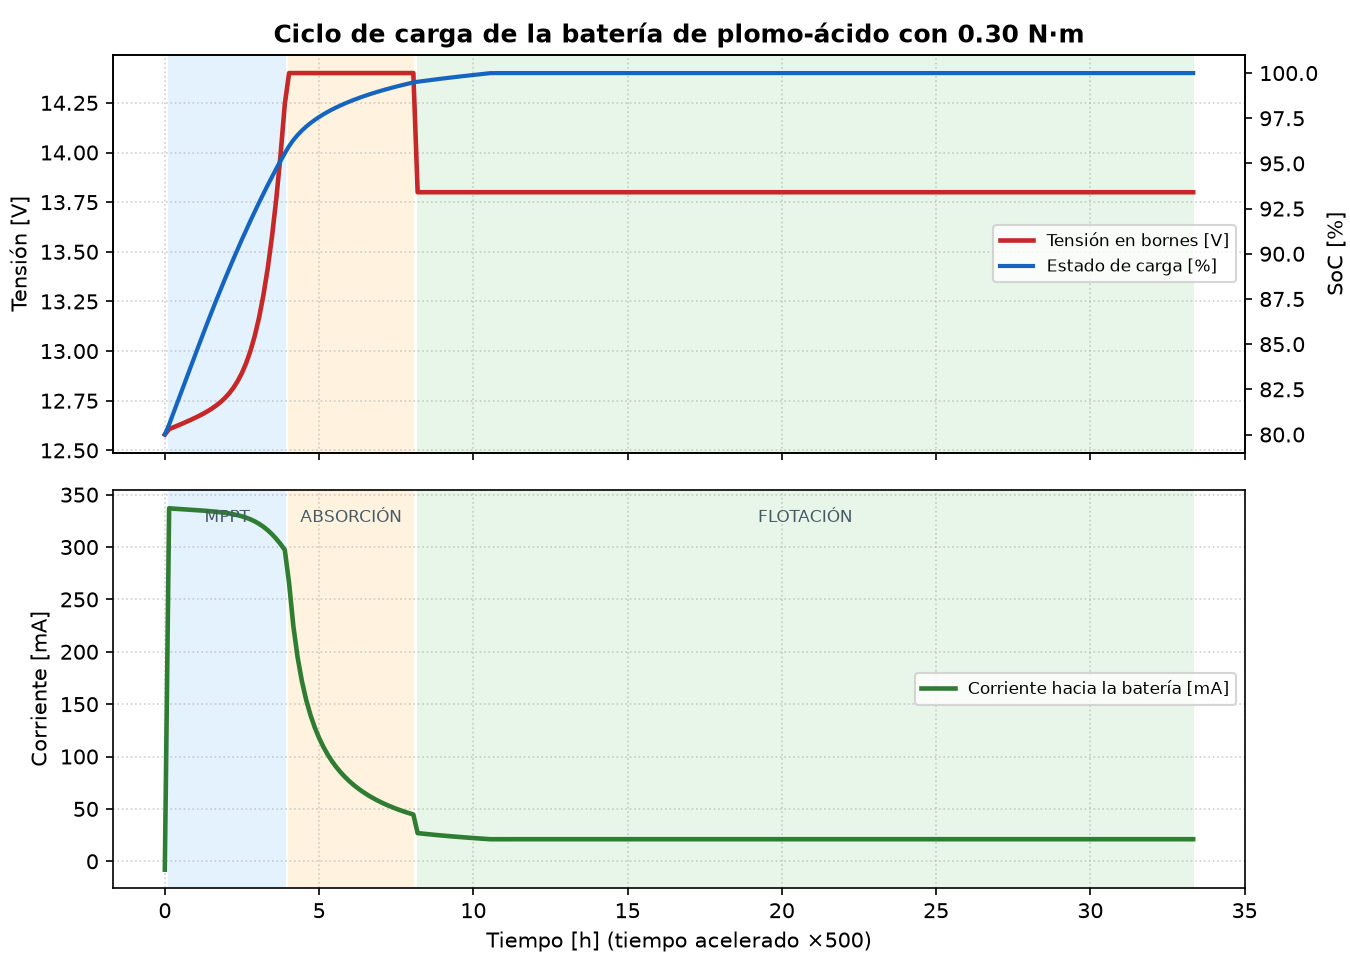
[picture p19: figure]

Figura 3: Ciclo de carga completo desde el 80 % con 0.30 N·m: MPPT hasta las 4.0 h, absorción a 14.4 V hasta las 8.2 h y flotación con 21 mA.

## 5 Inversor y controlador

Pentrada = P0 + PAC + k P²

AC, | P0 = 3.6 W, | k = 5.81 × 10⁻⁴ W⁻¹
(η = 90 % a 150 W).

El inversor se desconecta cuando la tensión en bornes baja de 10.8 V y vuelve a conectarse por encima de 12.3 V (histéresis). El controlador consume 8 mA de la batería permanentemente. Con 15 W de carga el inversor toma 18.7 W: con 0.07 N·m la batería se descarga a -1.48 A.

## 6 Dinámica del rotor

J ω˙ = τmotriz(ω) −

Pem + PF
ω
− τroz(ω), | τmotriz = τaj
1 −

ω
ω0
, τroz = Tc + b ω + kvω

2

J = 2.415 × 10⁻⁴ kg·m2 (disco de PLA menos los alojamientos, imanes NdFeB y eje de acero).

Rozamiento de los rodamientos 608 y del aire: Tc = 3.0 mN·m (con rozamiento estático en reposo), b = 15.0 µN·m·s, kv = 15.0 nN·m·s2.

Fuente motriz lineal (motor DC o manivela) con velocidad en vacío ω0 = 1500 RPM y par ajustable hasta 0.30 N·m.

Integración con subpasos de 5 ms; las variables lentas (SoC, Vp, T) avanzan con el factor de aceleración del tiempo y la mecánica siempre en tiempo real.

Resultado · régimen con 0.07 N·m

Velocidad 483 RPM; potencia en el eje 2.40 W; potencia electromagnética 2.21 W; pérdidas en el cobre 0.986 W y por rozamiento 0.192 W; a la batería llegan 0.96 W (eficiencia eje → batería del 40 %). Con el par máximo (0.30 N·m) el rotor gira a 1002 RPM y carga con 4.35 W.

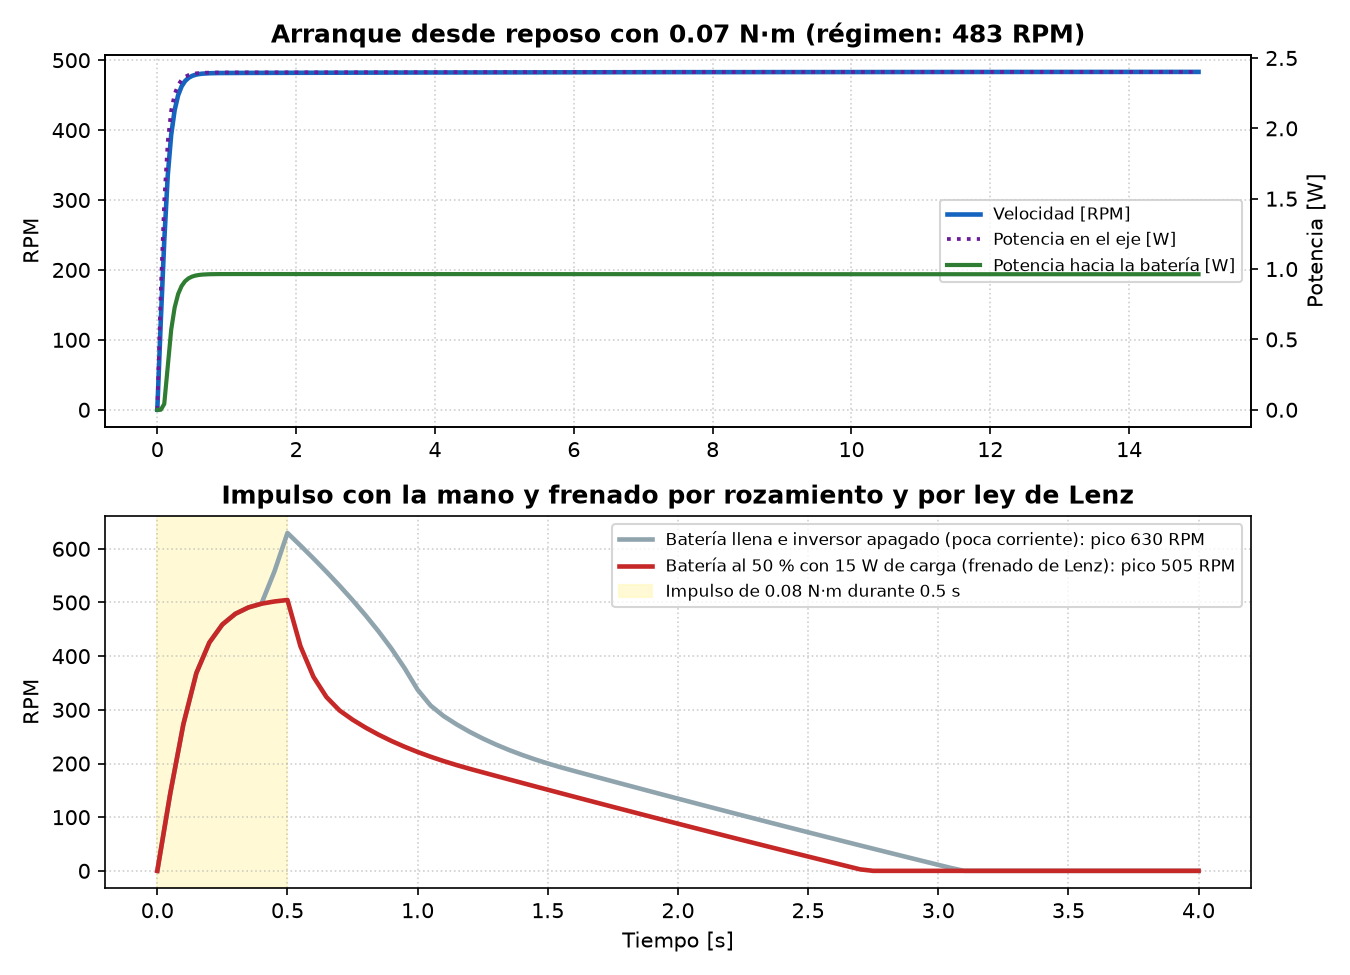
[picture p20: figure]

Figura 4: Arriba: arranque desde reposo. Abajo: impulso con la mano (0.08 N·m durante 0.5 s): pico de 505 RPM y parada 2.7 s después. La corriente de carga frena el rotor (ley de Lenz).

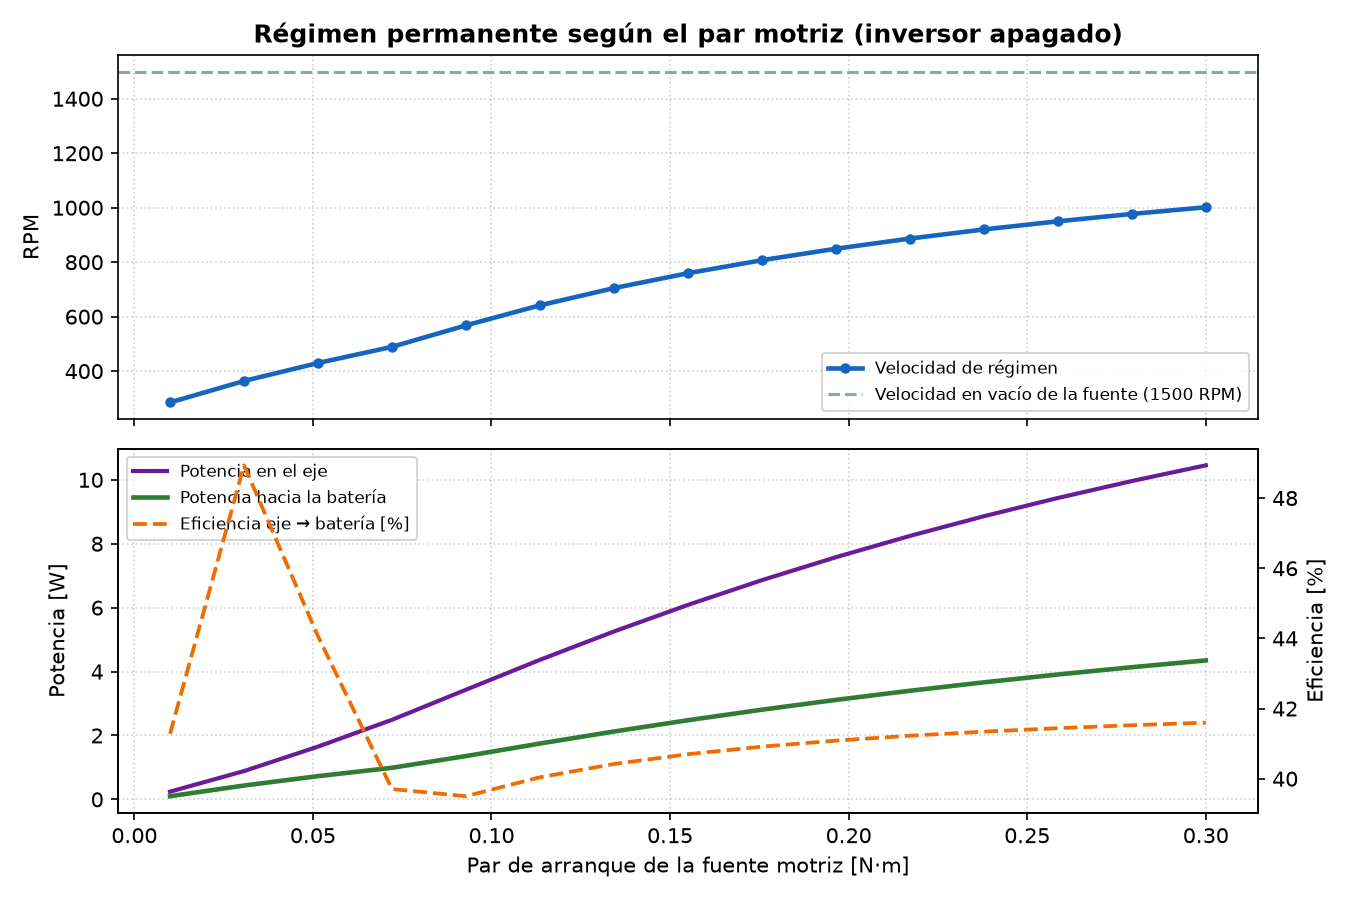
[picture p21: figure]

Figura 5: Régimen permanente según el par. A bajo par el controlador queda limitado por la tensión mínima del bus (3.5 V) y opera con menos corriente, lo que explica el máximo local de eficiencia.

## 7 Modelo térmico

Ct T˙ = PCu + PF − hA (T − Tamb), | h = hn + hf ω, | Br(T) = Br,20 -

1 + αB(Tamb − 20 ◦C)

Con Ct = 100 J/K, hn = 8 W/m2K, hf = 0.15 W/m2K por rad/s, αB = −0.12 %/K. Con 0.07 N·m las bobinas se estabilizan en 27.8 °C; el visualizador avisa si superan 55 °C, temperatura a la que el PLA empieza a ablandarse.

## 8 Verificación

tests/test_modelo_realista.py: geometría de la lente, perfil de flujo, Wheeler, inercia, MPPT, rizado, batería (polarización, Peukert, gasificación), inversor, validaciones, equilibrio de pares, conservación de la energía en cada paso, frenado de Lenz, etapas de carga, histéresis del corte y calentamiento.

tests/test_paridad_visualizador.py: Python y JavaScript dan los mismos parámetros, perfil, inercia y serie temporal completa en cuatro guiones.

tests/test_interfaz_visualizador.py: en un navegador real, cada control de la interfaz se acciona y lo que muestra el panel se compara con SimulacionDinamica de Python en el mismo estado.
