EmanuelOrozco/axial-flux-generator/docs/latex/02_memoria_de_calculo.tex

\documentclass[11pt]{article}
\newcommand{\nombredocumento}{02 · Memoria de cálculo}
\input{comun/preambulo.tex}

\begin{document}

\portada{Memoria de cálculo}
        {Cálculo numérico paso a paso del prototipo: campo, flujo, tensión, resistencia, potencia y par}
        {Documento 2 de 5 · Resultados del modelo analítico}

\tableofcontents
\newpage

%=====================================================================
\section{Cómo se obtuvo cada número}
%=====================================================================
Todos los valores de este documento se escriben a partir del archivo
\archivo{docs/latex/generado/valores.tex}, que genera automáticamente el comando
\begin{lstlisting}[style=consola]
uv run generador-axial reporte
\end{lstlisting}
a partir del diseño definido en \archivo{src/generador_axial/configuracion.py}. Si se cambia un parámetro del
diseño (por ejemplo, el número de espiras) y se recompilan los PDF con \archivo{docs/compilar_pdf.sh}, todas las
cifras de este documento se actualizan solas. Así se evita que la documentación y el código digan cosas distintas.

Cada paso sigue la misma estructura: \textbf{fórmula} (deducida en el Documento~1) $\rightarrow$
\textbf{sustitución} de los datos $\rightarrow$ \textbf{resultado}.

%=====================================================================
\section{Datos de entrada}
%=====================================================================
\begin{table}[H]
\centering
\caption{Parámetros del diseño.}
\begin{tabular}{llr}
\toprule
Símbolo & Descripción & Valor\\
\midrule
$B_r$ & Remanencia del imán (grado \ValGradoIman) & \ValBr\ T\\
$R$ & Radio del imán ($\varnothing$\,\ValDiametroIman\ mm) & \ValRadioIman\ mm\\
$L$ & Espesor del imán & \ValEspesorIman\ mm\\
$P$ & Número de polos & \ValPolos\\
$r_m$ & Radio de montaje de imanes y bobinas & \ValRadioMontaje\ mm\\
$N_b$ & Número de bobinas & \ValBobinas\\
$N$ & Espiras por bobina & \ValEspiras\\
$D_i,\ D_e$ & Diámetros interior y exterior de la bobina & \ValDiametroInteriorBobina\ / \ValDiametroExteriorBobina\ mm\\
$h$ & Altura (espesor axial) de la bobina & \ValAlturaBobina\ mm\\
$g$ & Entrehierro (cara del imán a cara de la bobina) & \ValEntrehierro\ mm\\
$k$ & Factor de acoplamiento & \ValAcoplamiento\\
AWG & Calibre del alambre (cobre $\varnothing$\,\ValDiametroCobre\ mm, esmaltado $\varnothing$\,\ValDiametroEsmaltado\ mm) & \ValCalibreAWG\\
$\rho_{Cu}$ & Resistividad del cobre a \SI{20}{\celsius} & \ValResistividadCobre$\times10^{-8}$\ $\Omega\cdot$m\\
$V_D$ & Caída por diodo (Schottky) & \ValCaidaDiodo\ V\\
$C$ & Condensador de filtro & \ValCapacitanciaMicro\ $\mu$F / \ValTensionNominalCondensador\ V\\
$R_{LED}$ & Resistencia limitadora del LED & \ValResistenciaLed\ $\Omega$, \ValPotenciaNominalResistenciaLed\ W\\
\bottomrule
\end{tabular}
\end{table}

%=====================================================================
\section{Campo magnético}
%=====================================================================

\begin{paso}{Paso 1 · Área de la cara del imán}
\[
  A_{im}=\pi R^2=\pi\,(\ValRadioIman\ \text{mm})^2=\ValAreaImanMM\ \text{mm}^2=\ValAreaImanM\times10^{-4}\ \text{m}^2 .
\]
\end{paso}

\begin{paso}{Paso 2 · Campo en la cara del imán ($z=0$)}
Con $z=0$ el segundo término de la fórmula del campo se anula:
\[
  B_z(0)=\frac{B_r}{2}\,\frac{L}{\sqrt{L^2+R^2}}
  =\frac{\ValBr}{2}\cdot\frac{\ValEspesorIman}{\ValRaizCaraIman}
  =\frac{\ValBr}{2}\cdot\ValTerminoCaraIman
  =\boxed{\ValCampoCaraIman\ \text{T}}
\]
(Las longitudes pueden ir en mm porque aparecen como cociente.)
\end{paso}

\begin{paso}{Paso 3 · Campo en la cara de la bobina ($z=g=\ValEntrehierro$ mm)}
\begin{align*}
  \frac{g+L}{\sqrt{(g+L)^2+R^2}}&=\frac{\ValEntrehierroMasEspesor}{\ValRaizGL}=\ValTerminoUnoG,\\
  \frac{g}{\sqrt{g^2+R^2}}&=\frac{\ValEntrehierro}{\ValRaizG}=\ValTerminoDosG,\\
  B_z(g)&=\frac{\ValBr}{2}\left(\ValTerminoUnoG-\ValTerminoDosG\right)=\boxed{\ValCampoCaraBobina\ \text{T}}
\end{align*}
\end{paso}

\begin{paso}{Paso 4 · Campo medio en el espesor de la bobina ($g\le z\le g+h$)}
Con $F(z)=\sqrt{(z+L)^2+R^2}-\sqrt{z^2+R^2}$ (en mm):
\begin{align*}
  F(g)&=\sqrt{(\ValEntrehierroMasEspesor)^2+\ValRadioIman^2}-\sqrt{\ValEntrehierro^2+\ValRadioIman^2}
       =\ValRaizGL-\ValRaizG=\ValPrimitivaEnG,\\
  F(g+h)&=\sqrt{(\ValEntrehierroAlturaEspesor)^2+\ValRadioIman^2}-\sqrt{\ValEntrehierroMasAltura^2+\ValRadioIman^2}
       =\ValRaizGHL-\ValRaizGH=\ValPrimitivaEnGH,\\
  \bar B_z&=\frac{B_r}{2h}\big[F(g+h)-F(g)\big]=\frac{\ValBr}{2\cdot\ValAlturaBobina}\cdot\ValDiferenciaPrimitivas
          =\boxed{\ValCampoMedioBobina\ \text{T}}
\end{align*}
El campo medio es un \ValReduccionPorPromedio\,\% menor que el campo en la cara de la bobina.
\end{paso}

\begin{figure}[H]
\centering

\caption{Campo axial $B_z(z)$. La franja azul es el volumen ocupado por las espiras; la línea horizontal es el
promedio $\bar B_z$ que se usa en el cálculo del flujo.}
\end{figure}

%=====================================================================
\section{Flujo magnético}
%=====================================================================
\begin{paso}{Paso 5 · Flujo máximo por espira}
\[
  \Phi_{max}=k\,\bar B_z\,A_{im}=\ValAcoplamiento\times\ValCampoMedioBobina\ \text{T}\times\ValAreaImanM\times10^{-4}\ \text{m}^2
  =\boxed{\ValFlujoMaximoMicro\ \mu\text{Wb}}
\]
\end{paso}

%=====================================================================
\section{Cinemática a \ValRpmReferencia\ RPM (velocidad de referencia)}
%=====================================================================
\begin{paso}{Paso 6 · Velocidades y frecuencia}
\begin{align*}
  \omega_m&=\frac{2\pi\cdot\text{RPM}}{60}=\frac{2\pi\cdot\ValRpmReferencia}{60}=\ValOmegaMecanicaRef\ \text{rad/s},\\
  f_e&=\frac{P\cdot\text{RPM}}{120}=\frac{\ValPolos\cdot\ValRpmReferencia}{120}=\boxed{\ValFrecuenciaRef\ \text{Hz}},\\
  \omega_e&=2\pi f_e=\frac{P}{2}\,\omega_m=\ValOmegaElectricaRef\ \text{rad/s},\qquad
  T_e=\frac{1}{f_e}=\ValPeriodoRefMs\ \text{ms}.
\end{align*}
\end{paso}

%=====================================================================
\section{Tensión inducida}
%=====================================================================
\begin{paso}{Paso 7 · Fem pico, eficaz y rectificada a \ValRpmReferencia\ RPM}
\begin{align*}
  N_{total}&=N_b\cdot N=\ValBobinas\times\ValEspiras=\ValEspirasTotales,\\
  V_{pico}&=N_{total}\,\omega_e\,\Phi_{max}=\ValEspirasTotales\times\ValOmegaElectricaRef\times\ValFlujoMaximoMicro\times10^{-6}
          =\boxed{\ValTensionPicoRef\ \text{V}},\\
  V_{pico,\,bobina}&=V_{pico}/N_b=\ValTensionPicoPorBobinaRef\ \text{V},\\
  V_{RMS}&=\frac{V_{pico}}{\sqrt2}=\frac{\ValTensionPicoRef}{1.4142}=\boxed{\ValTensionRmsRef\ \text{V}},\\
  V_{DC}&\approx V_{pico}-2V_D=\ValTensionPicoRef-\ValCaidaPuente=\boxed{\ValTensionDcRef\ \text{V}}.
\end{align*}
\end{paso}

\begin{figure}[H]
\centering

\caption{Flujo por espira $\Phi(t)$ y fem total $e(t)=-N_{total}\,\dif\Phi/\dif t$ a \ValRpmReferencia\ RPM. La fem
es máxima cuando el flujo pasa por cero (máxima pendiente) y nula cuando el flujo es máximo.}
\end{figure}

\begin{figure}[H]
\centering

\caption{Las tensiones crecen linealmente con la velocidad porque $V_{pico}\propto\omega_e\propto\text{RPM}$. El eje
superior muestra la frecuencia eléctrica correspondiente.}
\end{figure}

%=====================================================================
\section{Resistencia interna y ocupación de la bobina}
%=====================================================================
\begin{paso}{Paso 8 · Longitud de alambre}
\begin{align*}
  \ell_m&=\pi\,\frac{D_i+D_e}{2}=\pi\,\frac{\ValDiametroInteriorBobina+\ValDiametroExteriorBobina}{2}=\ValLongitudMediaEspira\ \text{mm},\\
  L_{bobina}&=N\,\ell_m=\ValEspiras\times\ValLongitudMediaEspira\ \text{mm}=\ValLongitudAlambreBobina\ \text{m},\\
  L_{total}&=N_b\,L_{bobina}=\ValLongitudAlambreTotal\ \text{m}.
\end{align*}
\end{paso}

\begin{paso}{Paso 9 · Resistencia}
\begin{align*}
  A_{Cu}&=\frac{\pi d^2}{4}=\frac{\pi\,(\ValDiametroCobre)^2}{4}=\ValAreaCobreMM\ \text{mm}^2,\\
  R_{bobina}&=\rho_{Cu}\,\frac{L_{bobina}}{A_{Cu}}=\ValResistenciaBobina\ \Omega,\\
  R_{int}&=N_b\,R_{bobina}=\boxed{\ValResistenciaInterna\ \Omega}.
\end{align*}
Este es el valor que debe medirse con el multímetro entre los terminales de salida (a \SI{20}{\celsius}).
\end{paso}

\begin{paso}{Paso 10 · ¿Caben las espiras? (factor de ocupación)}
La ventana de bobinado mide $\frac{D_e-D_i}{2}\times h=\ValVentanaBobinaMM$ mm$^2$. Si cada espira ocupa un cuadrado de
lado igual al diámetro esmaltado:
\[
  \text{ocupación}=\frac{N\,d_{esm}^2}{\text{ventana}}=\frac{\ValEspiras\times\ValDiametroEsmaltado^2}{\ValVentanaBobinaMM}=\boxed{\ValOcupacion}
\]
Un valor por debajo de $0.85$ es realizable con bobinado manual ordenado. El modelo rechaza diseños con
ocupación mayor que 1.
\end{paso}

%=====================================================================
\section{Operación con carga a \ValRpmCarga\ RPM}
%=====================================================================
\begin{paso}{Paso 11 · Máxima transferencia de potencia ($R_L=R_{int}=\ValResistenciaInterna\ \Omega$)}
\begin{align*}
  V_{RMS}&=\ValTensionRmsCarga\ \text{V}\quad(V_{pico}=\ValTensionPicoCarga\ \text{V a \ValRpmCarga\ RPM}),\\
  I&=\frac{V_{RMS}}{R_{int}+R_L}=\frac{\ValTensionRmsCarga}{2\times\ValResistenciaInterna}=\ValCorrienteCarga\ \text{A},\\
  V_{L}&=I\,R_L=\ValTensionEnCarga\ \text{V},\\
  P_L&=I^2R_L=\boxed{\ValPotenciaCarga\ \text{W}},\qquad P_{Cu}=I^2R_{int}=\ValPotenciaPerdidas\ \text{W}.
\end{align*}
\end{paso}

\begin{paso}{Paso 12 · Balance de energía y par de Lenz}
\begin{align*}
  P_{mec}&=P_L+P_{Cu}=\ValPotenciaMecanica\ \text{W},\\
  \omega_m&=\ValOmegaMecanicaCarga\ \text{rad/s},\\
  \tau&=\frac{P_{mec}}{\omega_m}=\boxed{\ValParResistenteMili\ \text{mN}\cdot\text{m}},\qquad
  \eta=\frac{P_L}{P_{mec}}=\ValEficiencia\ \text{\%}.
\end{align*}
Ese es el par adicional que la mano o el taladro deben vencer cuando el generador alimenta una carga adaptada.
\end{paso}

\begin{figure}[H]
\centering

\caption{Potencia en la carga en función de $R_L$: el máximo está exactamente en $R_L=R_{int}$.}
\end{figure}

\begin{figure}[H]
\centering

\caption{Con carga adaptada la potencia crece con el cuadrado de la velocidad ($P\propto V^2\propto\text{RPM}^2$) y el
par resistente crece linealmente ($\tau=P/\omega_m\propto\text{RPM}$).}
\end{figure}

%=====================================================================
\section{Verificación de la etapa de salida}
%=====================================================================
\begin{paso}{Paso 13 · Condensador, LED y rizado}
\begin{itemize}
  \item \textbf{Tensión máxima} a \ValRpmMaxima\ RPM: $V_{DC}=\ValTensionDcMaxima$ V. El condensador de
        \ValTensionNominalCondensador\ V queda con un margen del \ValMargenCondensador\,\% (uno de 25\,V se dañaría).
  \item \textbf{LED} a \ValRpmMaxima\ RPM:
        $I_{LED}=\dfrac{V_{DC}-V_{LED}}{R_{LED}}=\dfrac{\ValTensionDcMaxima-\ValCaidaLed}{\ValResistenciaLed}=\ValCorrienteLedMaxMili$ mA
        (límite \ValCorrienteLedLimiteMili\ mA) y la resistencia disipa
        $I^2R=\ValPotenciaResistenciaLedMax$ W (nominal \ValPotenciaNominalResistenciaLed\ W).
  \item \textbf{Rizado} a \ValRpmReferencia\ RPM con el LED como carga ($I=\ValCorrienteLedRefMili$ mA):
        \[
          \Delta V_{pp}=\frac{I}{2f_eC}=\frac{\ValCorrienteLedRefMili\times10^{-3}}{2\times\ValFrecuenciaRef\times\ValCapacitanciaMicro\times10^{-6}}
          =\ValRizadoRef\ \text{mV}.
        \]
\end{itemize}
\end{paso}

%=====================================================================
\section{Micro-red a \ValRpmMicrored\ RPM}
%=====================================================================
\begin{paso}{Paso 14 · Batería (estado inicial SoC = \ValSocInicial\,\%)}
\begin{align*}
  E&=V_{nom}\,C=\ValBateriaTension\ \text{V}\times\ValBateriaCapacidad\ \text{Ah}=\ValBateriaEnergia\ \text{Wh},\\
  E_{oc}&=\ValBateriaVacia+\ValBateriaPendiente\times0.\ValSocInicial=\ValTensionOcRef\ \text{V},\\
  E_{util}&=(\text{SoC}-\text{SoC}_{corte})\,E=(0.\ValSocInicial-0.\ValSocCorte)\times\ValBateriaEnergia=\ValEnergiaUtilRef\ \text{Wh}.
\end{align*}
El inversor se desconecta al \ValSocCorte\,\% y vuelve a conectarse al \ValSocReconexion\,\%.
\end{paso}

\begin{paso}{Paso 15 · Carga con seguimiento del punto de máxima potencia}
\begin{align*}
  V_{RMS}&=\ValFemRmsMicrored\ \text{V},\qquad V_{DC}=\ValTensionDcMicrored\ \text{V}>\ValControladorArranque\ \text{V (arranca)},\\
  P_{max}&=\frac{V_{RMS}^2}{4R_{int}}=\frac{\ValFemRmsMicrored^2}{4\times\ValResistenciaInterna}=\ValPotenciaExtraibleMicrored\ \text{W},\\
  P_{bat}&=\eta_c\,P_{max}=0.\ValControladorEficiencia\times\ValPotenciaExtraibleMicrored=\boxed{\ValPotenciaHaciaBateria\ \text{W}},\\
  I_{carga}&=\frac{P_{bat}}{E_{oc}}=\frac{\ValPotenciaHaciaBateria}{\ValTensionOcRef}=\ValCorrienteCargaMicroredMili\ \text{mA}
  \quad(<\ValControladorCorrienteMax\ \text{A, no se limita}),\\
  P_{mec}&=P_{max}+I^2R_{int}=\ValPotenciaMecanicaMicrored\ \text{W},\qquad
  \tau=\ValParMicroredMili\ \text{mN}\cdot\text{m}.
\end{align*}
Sin consumo, recargar del \ValSocInicial\,\% al 100\,\% tomaría
$(1-0.\ValSocInicial)\times\ValBateriaCapacidad/0.\ValCorrienteCargaMicroredMili\approx\ValHorasRecarga$\,h.
\end{paso}

\begin{paso}{Paso 16 · Inversor de \ValInversorTension\,V / \ValInversorTensionAlta\,V a \ValInversorFrecuencia\,Hz}
\begin{align*}
  V_{pico}&=\sqrt2\times\ValInversorTension=\ValInversorPico\ \text{V}\qquad
  (\sqrt2\times\ValInversorTensionAlta=\ValInversorPicoAlto\ \text{V}),\\
  \frac{N_2}{N_1}&\approx\frac{\ValInversorPico}{\ValBateriaTension}=\ValRelacionEspiras,\\
  I_{AC}&=\frac{P_{AC}}{V_{RMS}}=\frac{\ValPotenciaCargaAc}{\ValInversorTension}=\ValCorrienteAcMili\ \text{mA},\\
  P_{in}&=\frac{P_{AC}}{\eta_{inv}}=\frac{\ValPotenciaCargaAc}{0.\ValInversorEficiencia}=\ValPotenciaEntradaInversor\ \text{W},\qquad
  I_{descarga}=\frac{P_{in}}{E_{oc}}=\ValCorrienteInversorBateria\ \text{A}.
\end{align*}
La potencia de \ValPotenciaCargaAc\,W está muy por debajo de la nominal del inversor (\ValInversorNominal\,W).
\end{paso}

\begin{paso}{Paso 17 · Balance de la batería y autonomía}
\begin{align*}
  P_{neta}&=P_{bat}-P_{in}=\ValPotenciaHaciaBateria-\ValPotenciaEntradaInversor=\boxed{\ValPotenciaNetaBateria\ \text{W}},\\
  t_{auto}&\approx\frac{E_{util}}{|P_{neta}|}=\ValAutonomiaHoras\ \text{h}\quad
  (\ValAutonomiaParadoHoras\ \text{h con el generador parado}).
\end{align*}
\end{paso}

\begin{paso}{Paso 18 · Velocidad de equilibrio}
Como $P_{bat}\propto\text{RPM}^2$, la velocidad que anula $P_{neta}$ para \ValPotenciaCargaAc\,W es
\[
  \text{RPM}_{eq}=\ValRpmMicrored\sqrt{\frac{\ValPotenciaEntradaInversor}{\ValPotenciaHaciaBateria}}\approx\ValRpmEquilibrio\ \text{RPM}.
\]
Supera las \ValRpmMaxima\ RPM del prototipo: \textbf{con \ValPotenciaCargaAc\,W la batería siempre se descarga}.
Con \ValPotenciaCargaReducida\,W el equilibrio se alcanza a $\approx\ValRpmEquilibrioReducida$\,RPM.
\end{paso}

\begin{figure}[H]
\centering

\caption{Evolución del SoC y de la corriente neta durante 6\,h a \ValRpmMicrored\ RPM con cargas de 0, 5 y 15\,W.
La línea discontinua marca el corte del inversor.}
\end{figure}

\begin{figure}[H]
\centering

\caption{Tensión del generador a \ValRpmMicrored\ RPM frente a la salida del inversor a 110\,V y 220\,V.}
\end{figure}

\begin{figure}[H]
\centering

\caption{Potencia que llega a la batería frente al consumo del inversor. Los cruces son las velocidades de
equilibrio.}
\end{figure}

%=====================================================================
\section{Tabla de ensayos prevista}
%=====================================================================
\begin{table}[H]
\centering
\caption{Valores teóricos para el protocolo de pruebas (columnas en blanco: medidas del laboratorio).}
\small
\begin{tabular}{ccccccccc}
\toprule
Ensayo & RPM & $f_e$ [Hz] & $V_{pico}$ [V] & $V_{RMS}$ [V] & $V_{DC}$ [V] & $V_{RMS}$ med. & $V_{DC}$ med. & LED\\
\midrule
\filasdesde{generado/tabla_ensayos.tex}
\bottomrule
\end{tabular}
\end{table}

%=====================================================================
\section{Verificación automática del modelo}
%=====================================================================
El paquete de pruebas (\archivo{uv run pytest}) comprueba en cada cambio que:
\begin{enumerate}
  \item $B_z(0)$ coincide con $\frac{B_r}{2}\frac{L}{\sqrt{L^2+R^2}}$ y que a gran distancia el campo coincide con el de un
        dipolo equivalente (error menor al 0.1\,\%).
  \item El promedio analítico $\bar B_z$ coincide con una integración numérica de 20\,001 puntos (error relativo
        $<10^{-8}$).
  \item La fem calculada coincide con $-N_{total}\,\dif\Phi/\dif t$ obtenida por derivación numérica.
  \item La potencia máxima aparece en $R_L=R_{int}$ y se cumple $\tau\,\omega_m=P_L+P_{Cu}$.
  \item La salida DC no supera el 80\,\% de la tensión del condensador ni la potencia de la resistencia del LED.
  \item Las piezas STL son sólidos cerrados cuyo volumen coincide con el analítico (error menor al 0.5\,\%).
  \item La micro-red conserva la energía, respeta los límites del controlador, corta el inversor al \ValSocCorte\,\% y reconecta al \ValSocReconexion\,\%.
  \item El visualizador web (JavaScript) da exactamente los mismos resultados que Python.
\end{enumerate}

\end{document}
