EmanuelOrozco/axial-flux-generator/simulacion/graficas/06_curva_carga_bateria.png

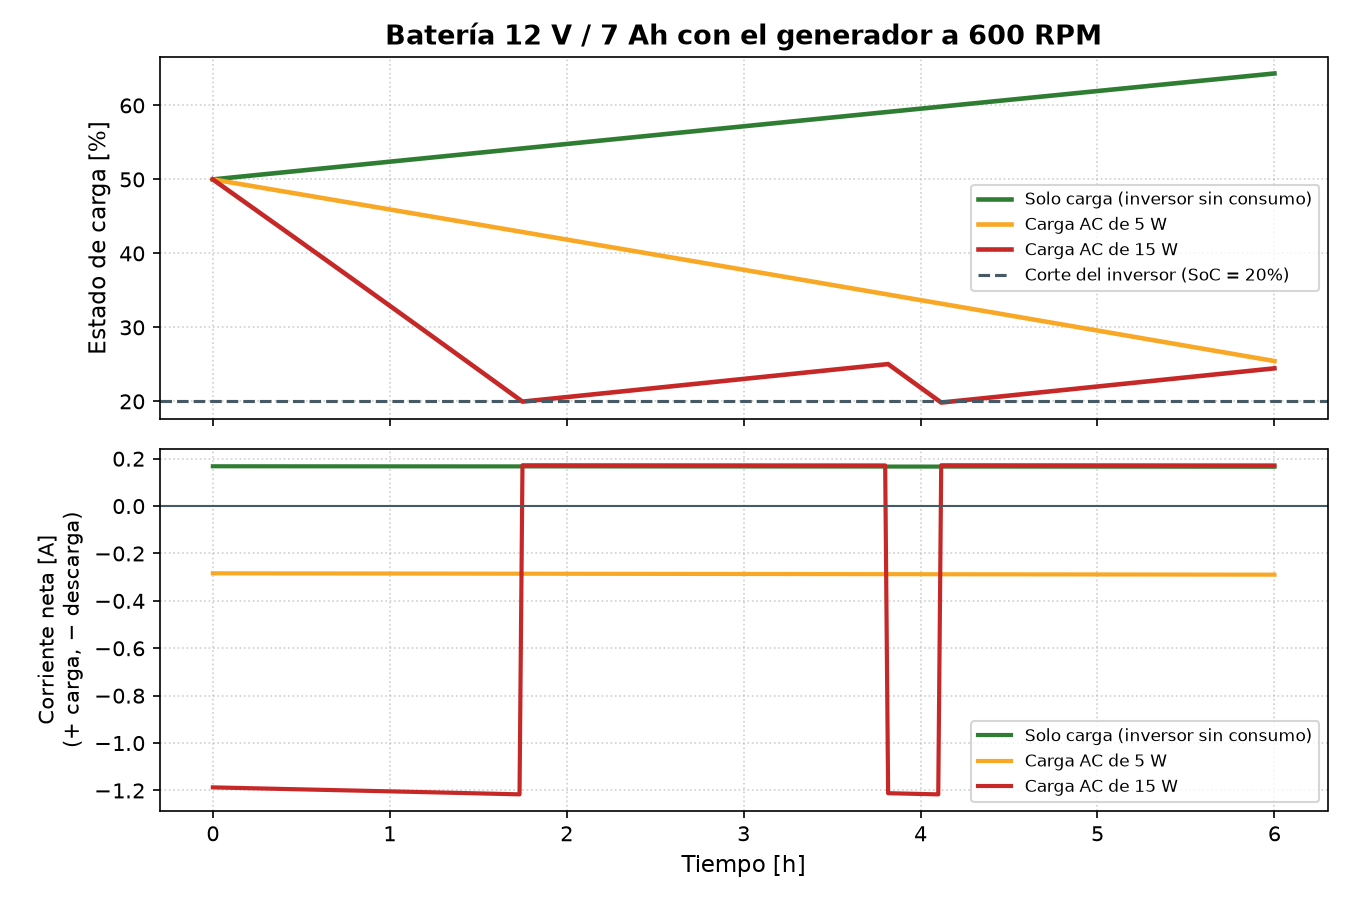
simulacion/graficas/06_curva_carga_bateria.png
