EmanuelOrozco/axial-flux-generator/simulacion/graficas/07_onda_inversor_110v_220v.png

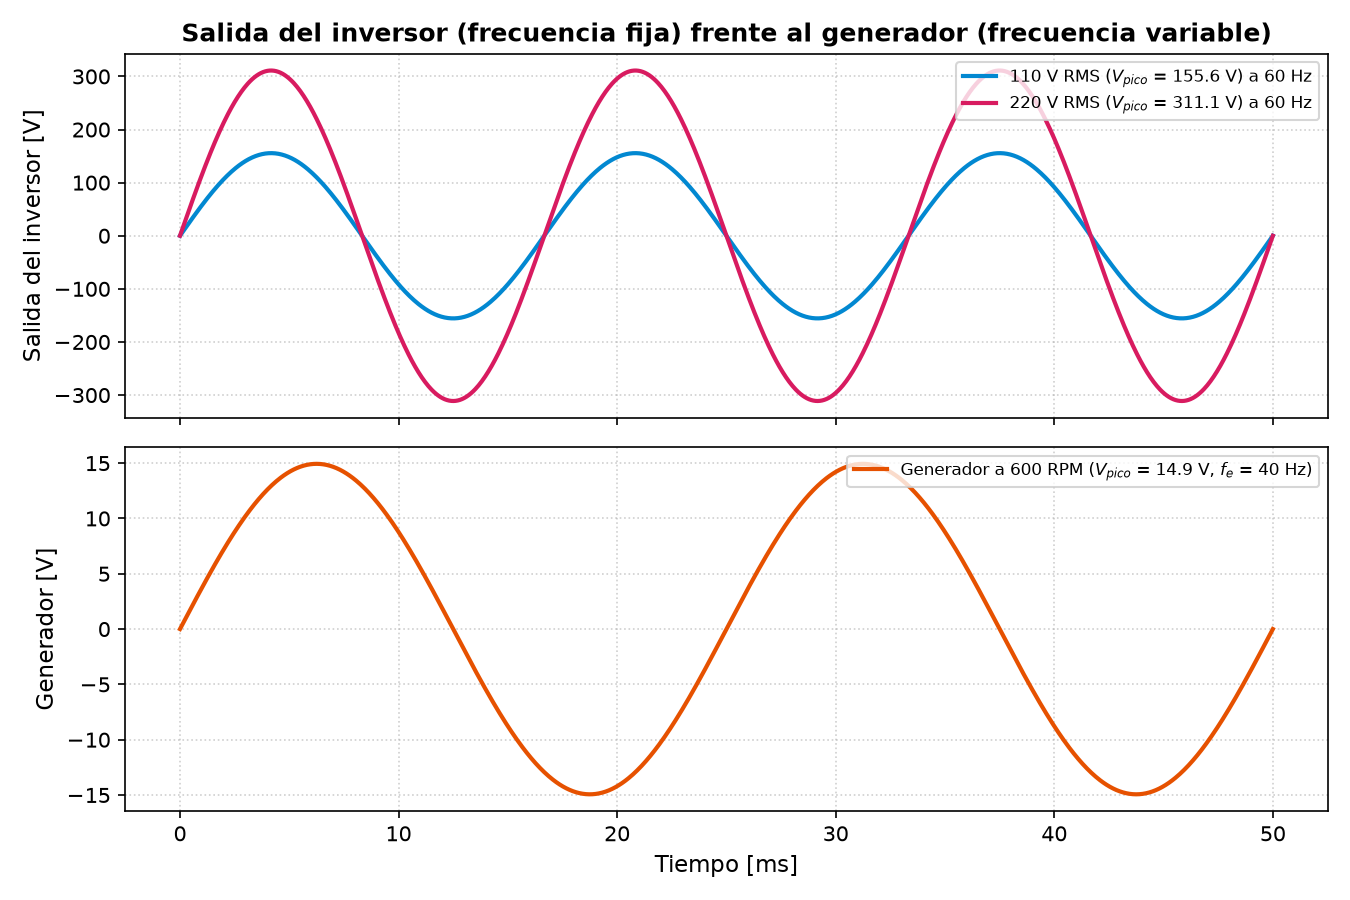
simulacion/graficas/07_onda_inversor_110v_220v.png
