EmanuelOrozco/axial-flux-generator/cad_3d/stl/disco_rotor_8_polos.stl

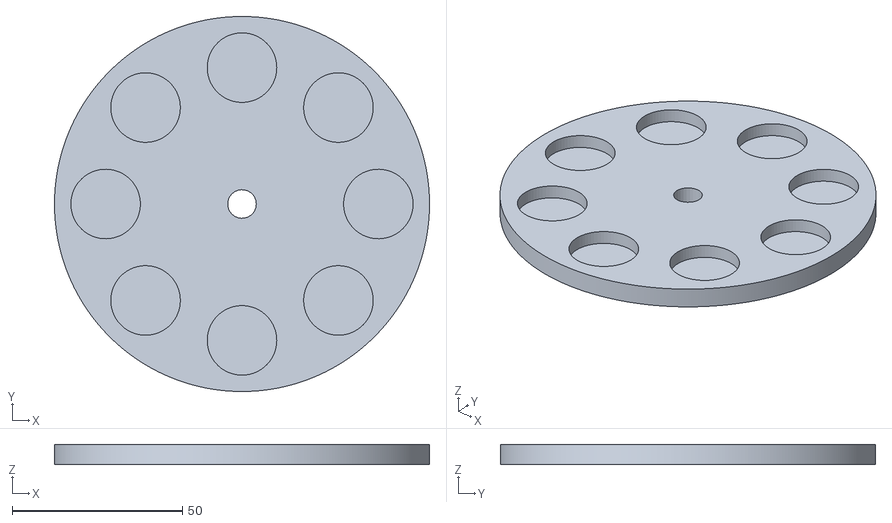
[picture p29: CAD file, 2026-10-12]
cad_3d/stl/disco_rotor_8_polos.stl
110.0 x 110.0 x 6.00
