EmanuelOrozco/axial-flux-generator/cad_3d/stl/carrete_tapa.stl

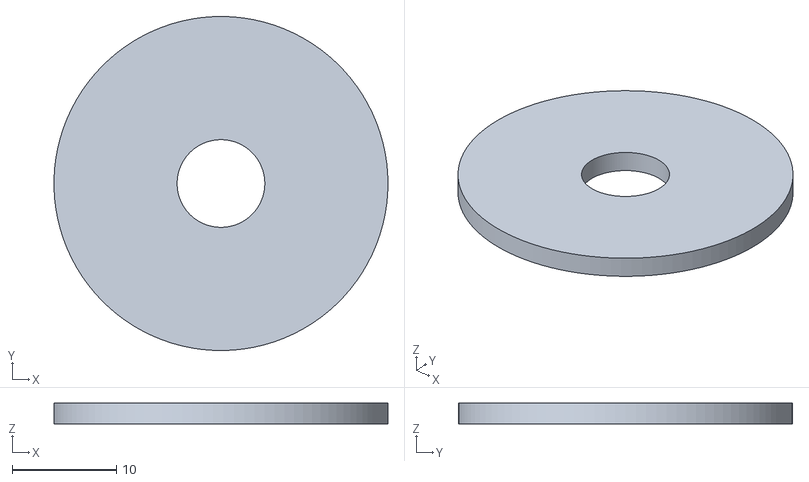
[picture p30: CAD file, 2026-10-12]
cad_3d/stl/carrete_tapa.stl
32.0 x 32.0 x 2.00
