EmanuelOrozco/axial-flux-generator/cad_3d/stl/carrete_base.stl

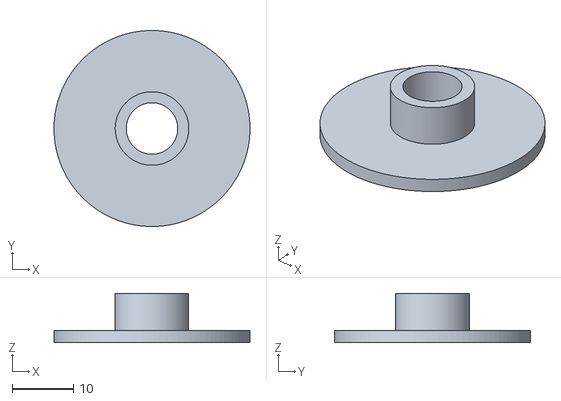
[picture p31: CAD file, 2026-10-12]
cad_3d/stl/carrete_base.stl
32.0 x 32.0 x 8.00
