EmanuelOrozco/axial-flux-generator/cad_3d/stl/disco_estator_soporte.stl

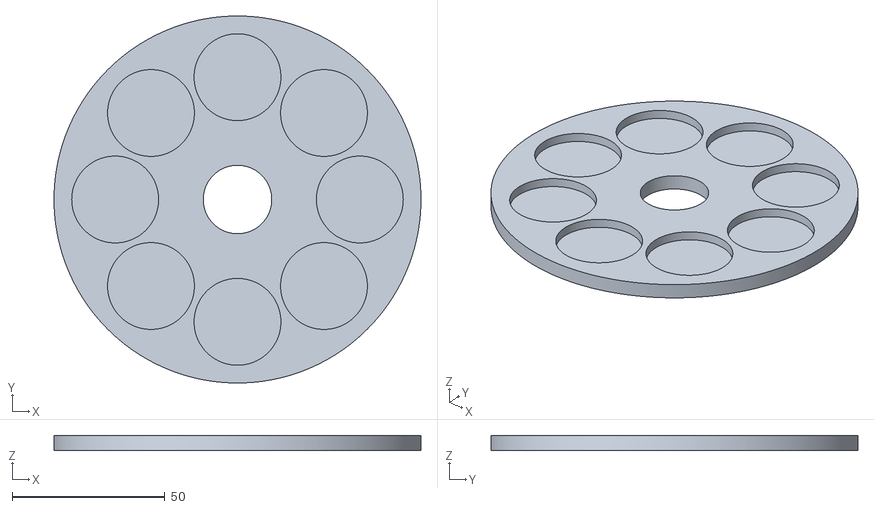
[picture p32: CAD file, 2026-10-12]
cad_3d/stl/disco_estator_soporte.stl
120.0 x 120.0 x 5.00
