EmanuelOrozco/axial-flux-generator/(commit log)

2026-10-12 chore: set up Python project with uv
    - Define the generador-axial package, its runtime dependencies (numpy, matplotlib)
    and the generador-axial console entry point.
    - Configure pytest: the slow browser tests are tagged with the 'interfaz' marker
    and excluded from the default run; add an 'e2e' dependency group for Playwright.
    - Pin all dependency versions in uv.lock for reproducible installs.
    - Ignore the virtual environment, Python/pytest caches, intermediate LaTeX
    build files, editor folders and local .env files.
    - Enforce LF line endings, mark PDF/PNG/STL as binary, and flag vendored and
    generated files so they do not skew GitHub language statistics.
2026-10-12 feat(domain): add generator components and physical models
    - Model every part of the system as a validated frozen dataclass: NdFeB magnet,
    8-pole rotor, coreless stator coils and AWG wire, bridge rectifier, DC LED
    indicator, 12 V battery, charge controller and 110/220 V inverter.
    - Reject impossible designs (odd pole count, overlapping magnets, more turns
    than fit in the coil window, invalid electrical limits) with ErrorDeDiseno.
    - Ideal steady-state physics based on Sadiku ch. 7-9: on-axis field of a
    cylindrical magnet, field averaged over the coil thickness, flux per turn,
    Faraday emf, electrical frequency, internal resistance and rectified DC.
    - Realistic physics:
    - magnet/tur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
2026-10-12 feat(app): add steady-state simulator, dynamic simulation and calculation report
    - SimuladorGenerador: steady-state operating points against RPM, matched-load
    power transfer, Lenz braking torque, micro-grid power balance, equilibrium
    speed for a given AC load and battery state-of-charge evolution.
    - SimulacionDinamica: time integration of the whole system with the driving
    torque as input. Rotor speed results from inertia, friction and Lenz braking.
    - MPPT is bounded by the minimum DC bus voltage, absorption (14.4 V) and float
    (13.8 V) setpoints, and the 3 A current limit.
    - Coupled lead-acid battery, inverter low-voltage disconnect with hysteresis,
    and a coil thermal node (copper r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
2026-10-12 test: cover physics, domain validation, micro-grid and realistic model
    - Faraday's law is checked against the numerical derivative of the flux, and the
    analytic mean field against numerical integration.
    - Maximum power transfer occurs at R_L = R_int; the mechanical/electrical
    energy balance and Lenz torque are consistent; no rotation means no voltage
    and no torque.
    - Design validation rejects invalid geometries and electrical parameters.
    - Micro-grid: controller start-up threshold, current and absorption limits,
    inverter cut-off and reconnection hysteresis.
    - Realistic model:
    - lens geometry, flux profile, Wheeler inductance and inertia;
    - MPPT optimum, ripple, Peukert and gassin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
2026-10-12 feat(cad): generate 3D-printable parts as binary STL
    - Build closed triangle meshes for the 8-pole rotor disc, the stator support
    disc and the two-piece coil winding bobbin, with magnet and coil pockets at
    the positions defined by the design.
    - Export binary STL in millimetres with a configurable maximum edge length
    for circular features.
    - Include the generated STL files so they can be printed without running Python.
    - Tests check that every part is a watertight solid, that its volume matches
    the analytic value, and that the STL binary format is valid.
    [carrete_base.stl, carrete_tapa.stl, disco_estator_soporte.stl, disco_rotor_8_polos.stl]
2026-10-12 feat(plots): add model plots and LaTeX macro export
    - Template Method base class for matplotlib figures, without global pyplot
    state.
    - 8 plots of the ideal model: B_z vs. distance, flux and Faraday emf, voltage
    vs. RPM, power vs. load, Lenz torque, battery charge curve, 110/220 V
    inverter output, and power balance vs. RPM.
    - 4 plots of the realistic model: real vs. sinusoidal waveform, start-up with
    hand impulse and coast-down, steady state vs. driving torque, and full
    lead-acid charge cycle with its stages highlighted.
    - LaTeX exporter that writes every report magnitude as a \Val... macro and
    generates the test table, so the PDFs always show the computed numbers.
    - Include the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
2026-10-12 feat(cli): add generador-axial command (simular, cad, reporte, todo)
    - Command pattern with one object per subcommand:
    - simular: prints a design summary and exports all plots;
    - cad: exports the STL parts;
    - reporte: writes the LaTeX macros;
    - todo: runs the three in sequence.
    - Console summary formatter for the design and the operating point.
    - Thin wrapper scripts in simulacion/ and cad_3d/ for running without
    installing the package.
    - Tests check that report values match the simulator, that report keys are
    valid LaTeX macro names, and that every subcommand runs.
2026-10-12 feat(viewer): port the physical models to JavaScript with exact Python parity
    - config.js mirrors configuracion.py and the realistic parameters.
    - fisica.js holds the ideal model; dinamica.js is an operation-by-operation
    mirror of SimulacionDinamica.
    - estado.js is an observable UI state (Observer pattern) that notifies only
    the keys that changed.
    - All modules are UMD, so they run both in the browser and in Node.
    - Parity tests run the JS models in Node and compare them with Python:
    - configuration and realistic parameters must be identical;
    - flux profile and inertia must match;
    - four scripted scenarios (start-up and charging, absorption, float,
    low-voltage cut-off) must mat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
2026-10-12 feat(viewer): add interactive interface and physically based 3D scene
    - Controls:
    - driving torque slider (0-0.30 N·m) and a hand-impulse button
    (0.08 N·m for 0.5 s);
    - time selector (1x, 10x, 50x, 500x) that accelerates only battery and
    thermal states;
    - ambient temperature, filter capacitor (220-4700 uF), air gap, turns
    and magnet remanence;
    - AC load, 110/220 V output and inverter switch.
    - Telemetry panel:
    - generator: peak voltage, frequency, DC voltage, shaft torque and power;
    - battery: coil temperature, charge stage, state of charge, battery
    voltage and net current;
    - alerts for excessive ripple, low-voltage cut-off and coil temperature
    above the P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
2026-10-12 test(viewer): add end-to-end UI tests with Playwright
    - Drive every control in a real Chromium browser (software WebGL) and compare
    the panel against Python's SimulacionDinamica evaluated in the same state.
    - Cover:
    - torque balance at steady state and hand-impulse timing;
    - time-acceleration factor and capacitor ripple;
    - temperature effects on the coils and the magnet;
    - absorption and float stages, and low-voltage cut-off with hysteresis;
    - oscilloscope frequency, crest factor and scales;
    - pause behaviour, PBR renderer setup, cameras, drawer, modal, popup
    window and responsive layout.
    - Excluded from the default run; run with: pytest -m interfaz.
2026-10-12 docs: add LaTeX sources and Markdown guides
    - Doc 1: theoretical framework derived from Sadiku ch. 7-9.
    - Doc 2: step-by-step calculation report.
    - Doc 3: fabrication guide with bill of materials and 110/220 V safety notes.
    - Doc 4: software architecture.
    - Doc 5: realistic dynamic model (real waveform, electronics limits,
    lead-acid battery, inverter, rotor dynamics and thermal model).
    - Shared preamble and auto-generated value macros, so the documents never
    disagree with the code.
    - compilar_pdf.sh regenerates plots, STL and macros, then compiles all PDFs.
2026-10-12 docs: add compiled PDFs of the five documents
    - Ready-to-read versions of the theoretical framework, calculation report,
    fabrication guide, software architecture and realistic model.
    - Regenerate them with ./docs/compilar_pdf.sh after any design change.
2026-10-12 docs: add README with project structure, quick start and results
    - Overview of the axial-flux generator and its micro-grid: rectifier, MPPT
    controller, 12 V battery and 110/220 V inverter.
    - Project tree, uv commands, test commands and how to launch the 3D viewer.
    - Key results tables for the ideal model and the realistic dynamic model.
2026-10-12 docs: add 10-minute presentation with live simulator demo
    - Beamer 16:9 deck (10 slides) covering the system, Faraday/Lenz physics,
    generator design, realistic model, battery charging, software architecture,
    live demo, results and conclusions.
    - Slide values come from the generated LaTeX macros and plots, so the deck
    stays in sync with the model.
    - Add simulator screenshots as a fallback if the live demo fails.
    - Add a timed speaker script (9:00 planned + 1:00 margin) with a step-by-step
    3:30 demo guide.
    - Include the presentation in compilar_pdf.sh and list it in the README.
2026-10-12 docs: adapt presentation for a general audience
    - Replace equations with plain-language explanations and everyday
    analogies (bicycle dynamo, coin-sized magnets, turns per second).
    - Add an illustrated three-step slide on how a moving magnet induces current.
    - Explain the results in everyday terms (LED vs 15 W bulb, 4 out of 10).
    - Replace the software architecture slide with a short 'why trust the
    simulation' slide.
    - Remove the possible-improvements box and close with a key takeaway message.
    - Rewrite the speaker script and demo guide in non-technical language
    (8:50 planned + 1:10 margin).
2026-10-12 docs: sync all documents with the current project
    - Architecture doc: add realistic-model modules, real test counts (109 + 29),
    e2e commands, --navegador flag and six-document build.
    - Theory and build guides: fix float voltage, 31 % wording, Buck-Boost
    diagram, broken \approx, turn limit, inverter cut-off (10.8 / 12.3 V) and
    note where values come from the ideal model.
    - Presentation: remove battery heating claim, clarify parity wording;
    script now pauses the simulator after reloading.
    - README: Python 3.11+, --navegador flag, e2e duration.
    - Rebuild all PDFs.
